MrSamuelLaw/robo-hobos/Ex 2/Media/unnamed (38).jpg

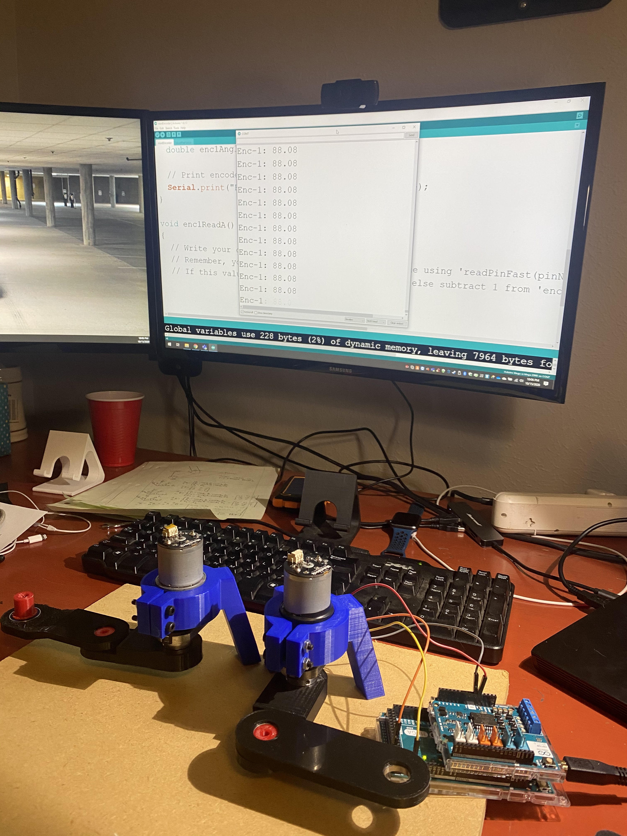
Ex 2/Media/unnamed (38).jpg
