MrSamuelLaw/robo-hobos/Ex 2/Media/unnamed (1).jpg

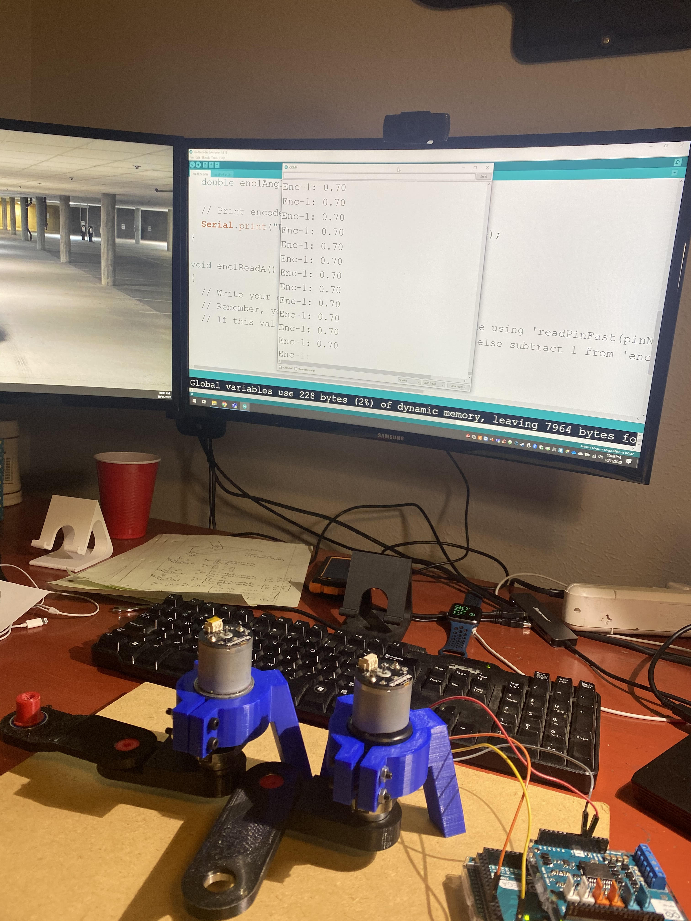
Ex 2/Media/unnamed (1).jpg
