MrSamuelLaw/robo-hobos/Ex 3/Exercise 3 Write-up.pdf

# Intro to Robotics Exercise 3

## Samuel Law & Rhys Miller

# System Diagram

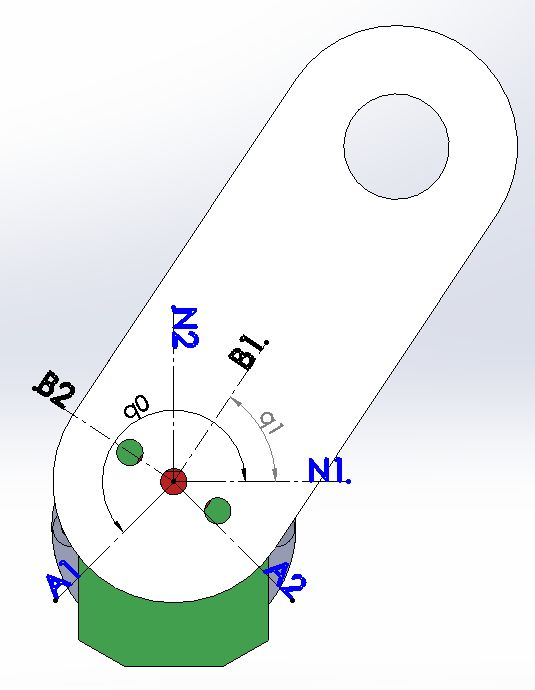
[picture p16: figure]

The system is shown below. The shaft (the top of which is a red circle) is considered body A, and the link is body B. The shaft’s A.3 axis is in the same direction as the N.3 and B.3 axis, however, the A.1 axis is at an angle q0 from the N.1 axis, not an angle q1. The COM of body A is assumed to be on its polar axis. The COM of body B is assumed to be at the dot next to the text B1. which is a distance LB away from point N, which is located at the origin.
The constraints equation is | where the q’s are the generalized coordinates and gr
is the gear ratio between the motor shaft and the motor output spindle. The constraint equation carries to both the velocity and acceleration terms.
Thus the system has two generalized coordinates, q0 and q1, and a single gear constraint equation, thus the system has a single degree of freedom
The gear ratio used in the gear constraint was printed on the side of the motor.

# Mass Properties

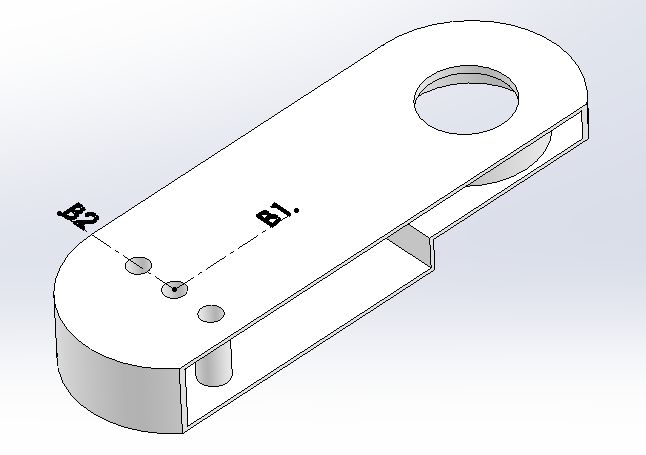
[picture p17: figure]
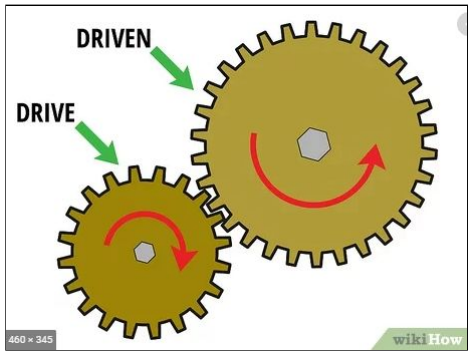
[picture p18: figure]

The mass for the link, body B, was computed using ABS mass properties from SolidWorks applied to the CAD model. The model was hollowed out, and the shell thickness set to 0.90 mm, the same as was used to print the physical model. The internally printed structure was neglected as a sparse infill was used.

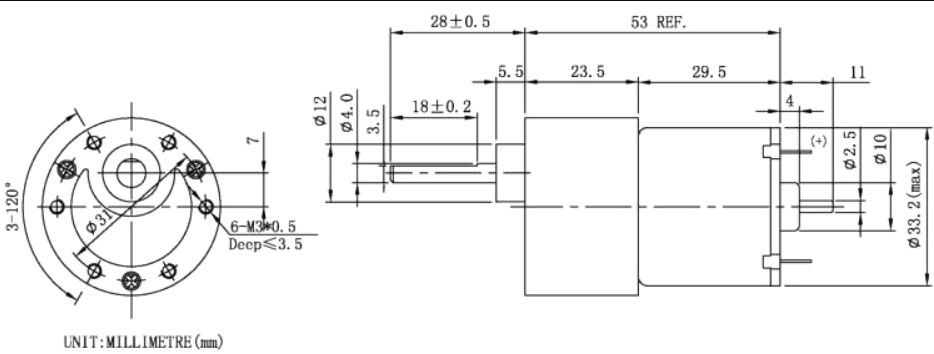
[picture p19: figure]

The mass of the axle that spins in body A was calculated using the drawing shown above. The axle was assumed to be 10.0 mm in diameter and 53 mm in length. A CAD model was generated, and the mass estimated with steel mass properties applied to the CAD model. The gears were assumed to interact in a manner similar to the ones shown below

The moments of inertia for both bodies were evaluated in the same manner as the mass properties.

Body | Mass [kg] | Izz [kg m² ]
Body A | 26.45 x 10 -3 | 3.30 x 10 -7
Body B | 7.28 x 10 -3 | 6.39 x 10 -6

# Equations of Motion

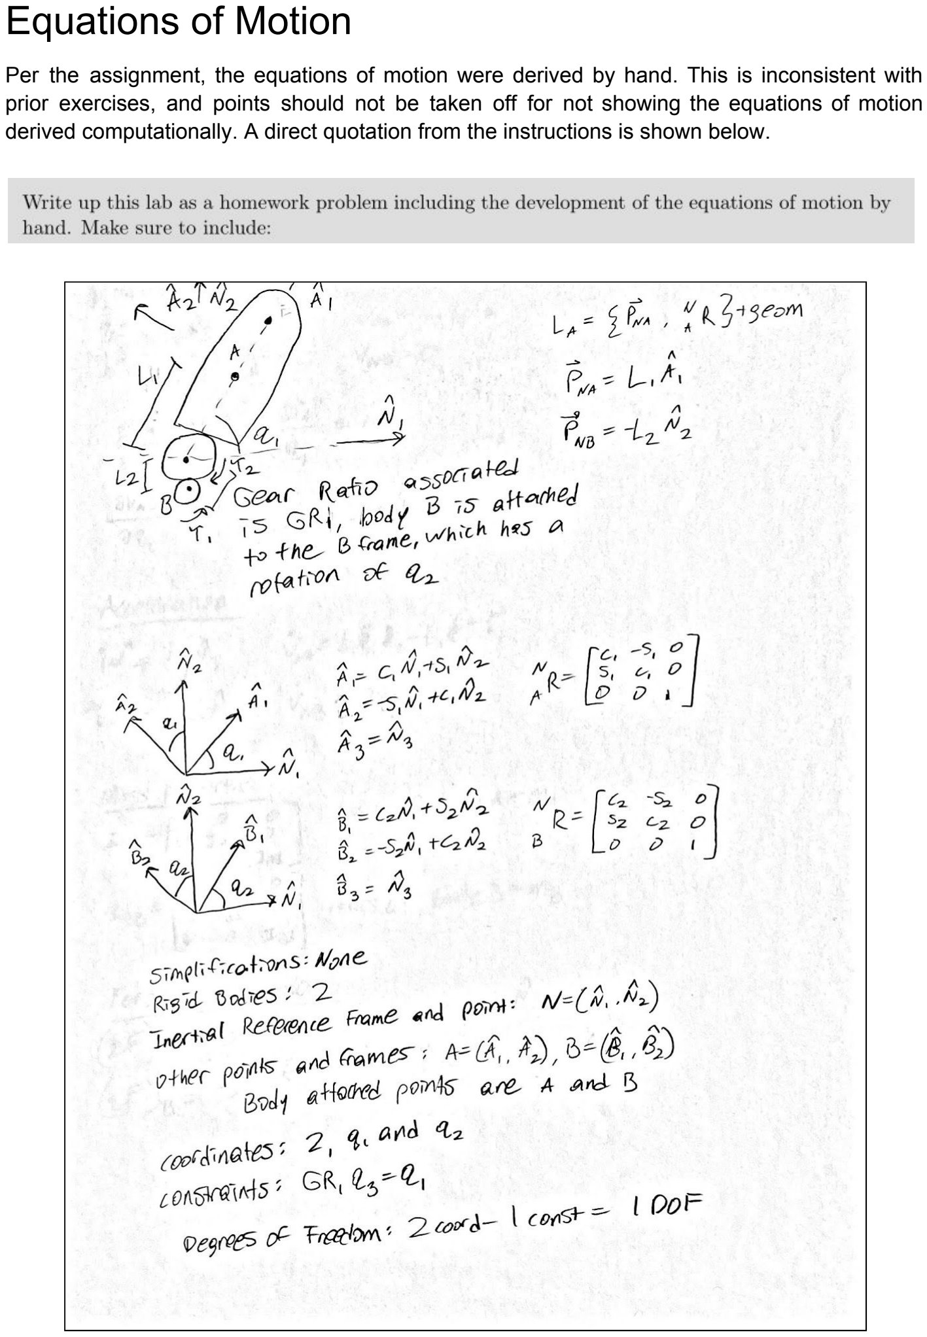
[picture p20: page 4]

Per the assignment, the equations of motion were derived by hand. This is inconsistent with prior exercises, and points should not be taken off for not showing the equations of motion derived computationally. A direct quotation from the instructions is shown below.

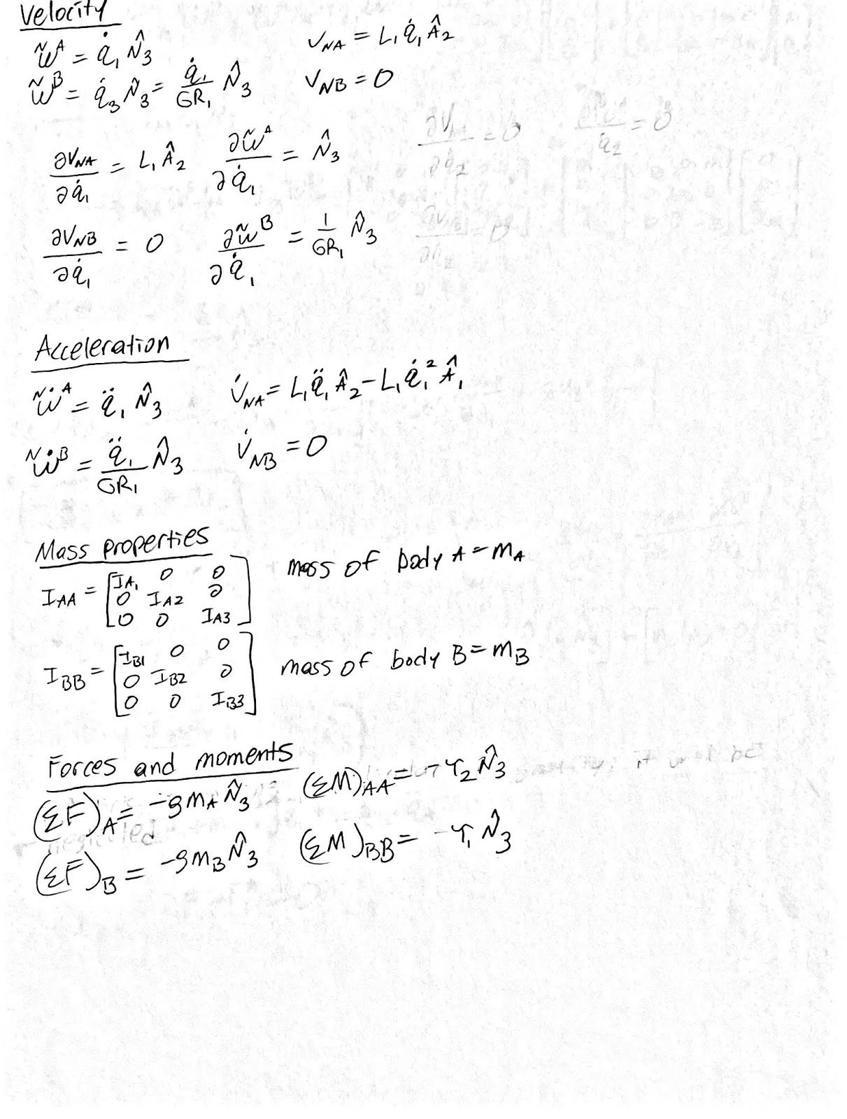
[picture p21: figure]

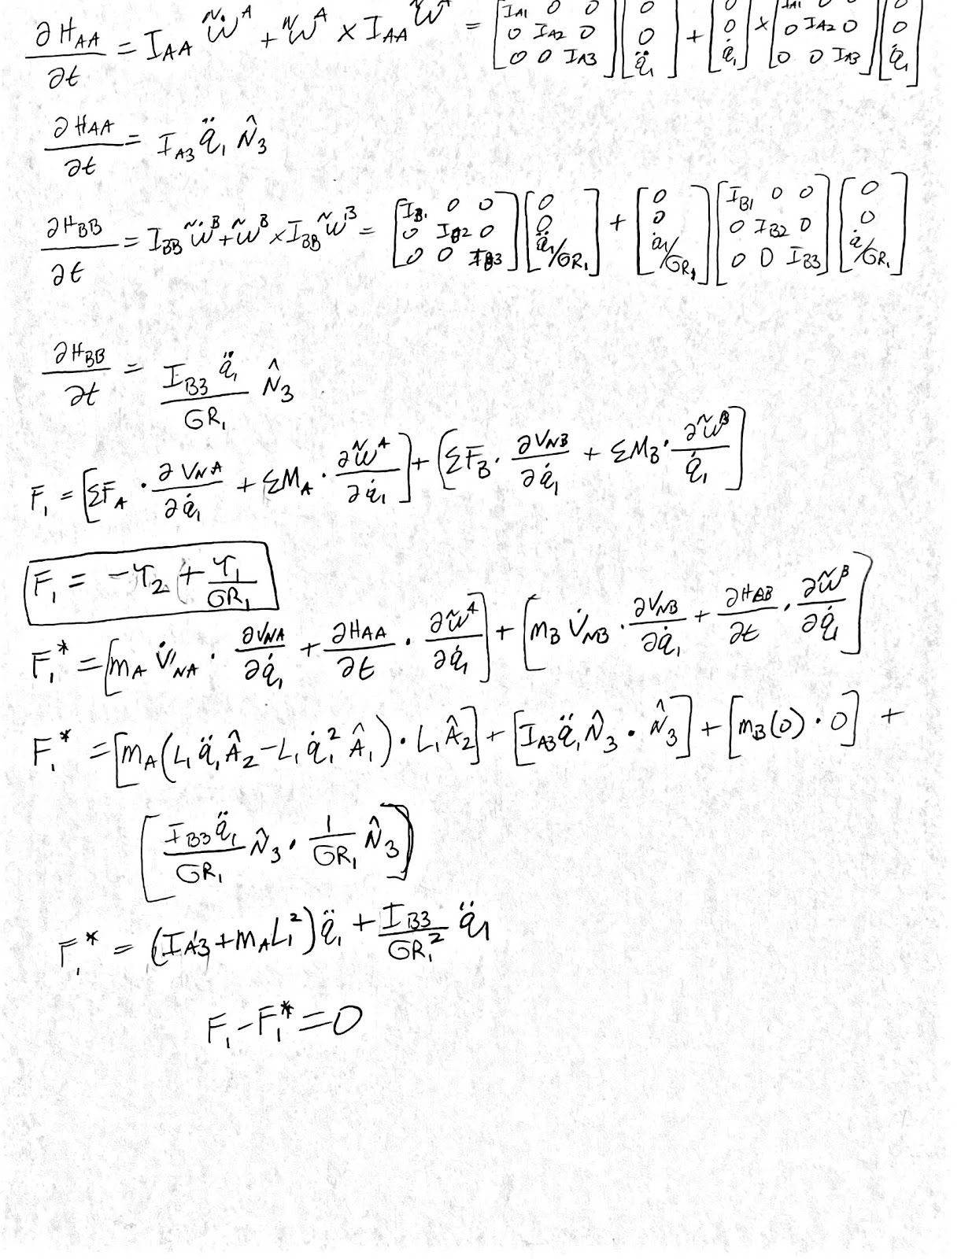
[picture p22: figure]

# Block Diagram & Discussion

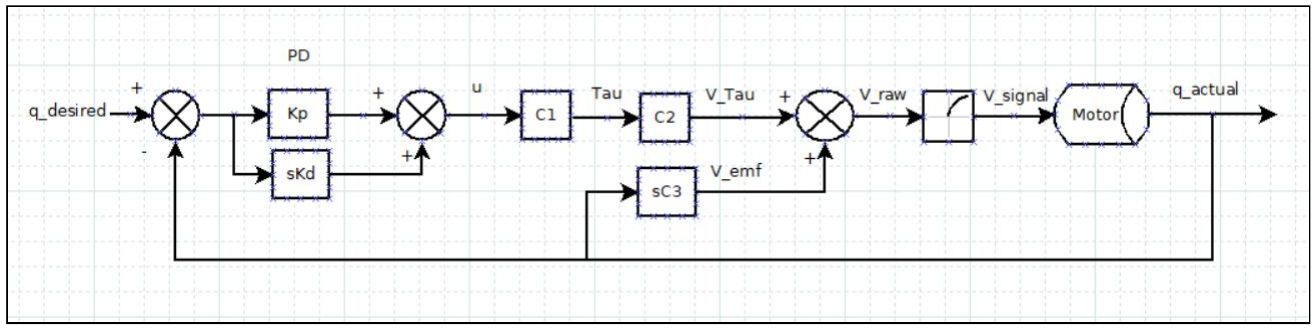
[picture p23: figure]

All simulations were performed using an RK45 integrator. The Kp value used was calculated based on the CPR of the encoder, which was set to 1000. The equation used is shown below, where Vmin is the minimum voltage required for the motor to begin moving. Vmin was determined via experimentation. For the joint space model, Kv was simply set so as to be critically damped. The saturation block between V_raw and V_signal indicates that the voltage signal was constrained between 0 and 12 volts.

The only change in the block diagram for the PD controller was that the C1 block was removed, thus eliminating any kind of compensation for mass properties. This meant that the controller had to be tuned in order to work correctly.

# Joint Space Simulation & Experiment Results

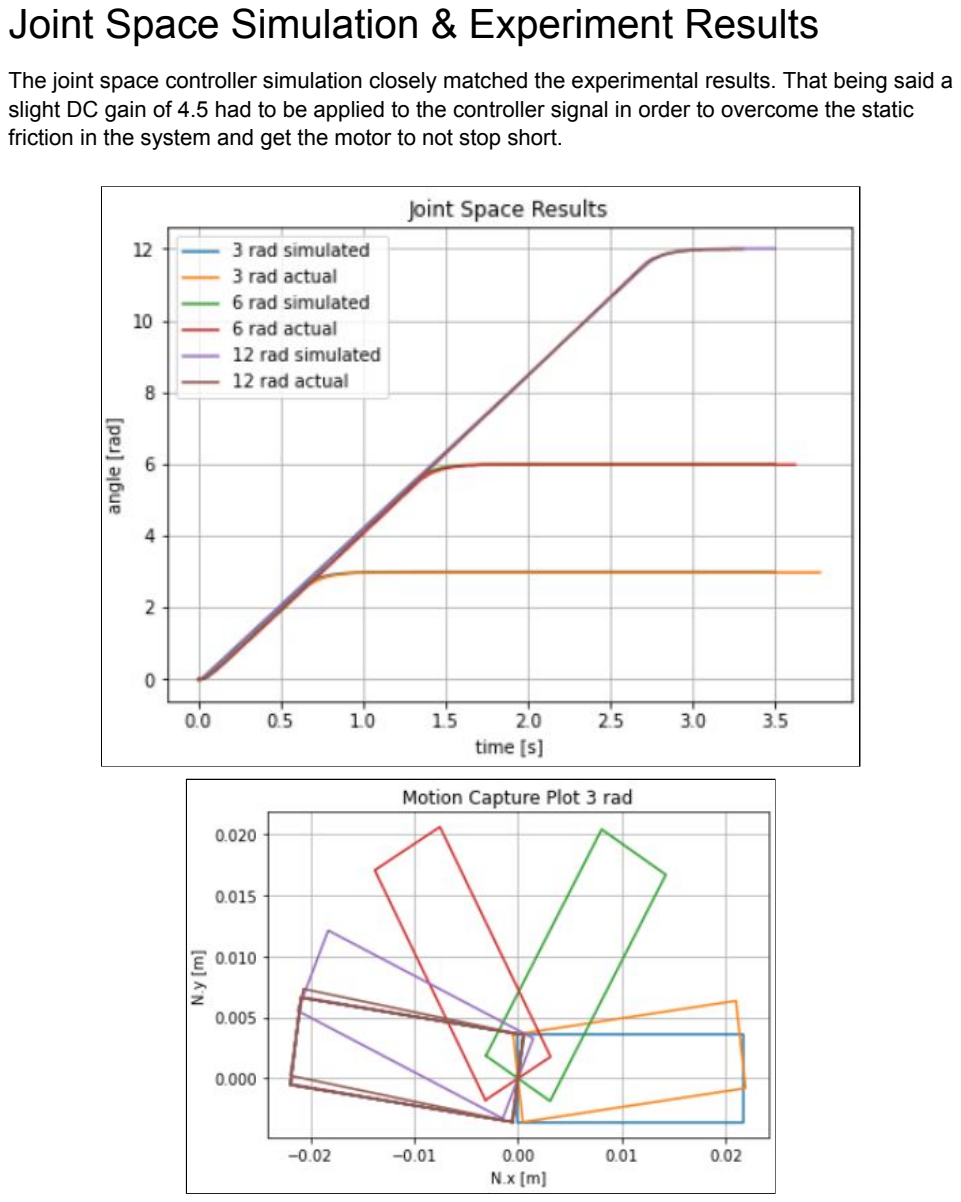
[picture p24: page 8]

The joint space controller simulation closely matched the experimental results. That being said a slight DC gain of 4.5 had to be applied to the controller signal in order to overcome the static friction in the system and get the motor to not stop short.

# PD Simulation & Experiment Results

The PD controller did not behave as simulated. Due to the massive increase in the strength of the signal, as C1 was a very small number and now was absent from the controller, the controller required a DC gain of 0.5 to function in the realm of normal. There was also substantial vibration. A PID controller is recommended as it would allow for lower Kp and Kv values, while not undershooting the target.

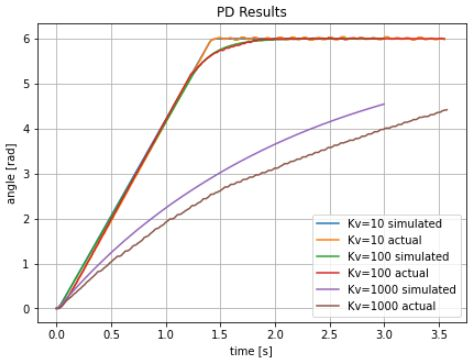
[picture p25: figure]

# Team Photo (note, only one person due to COVID)

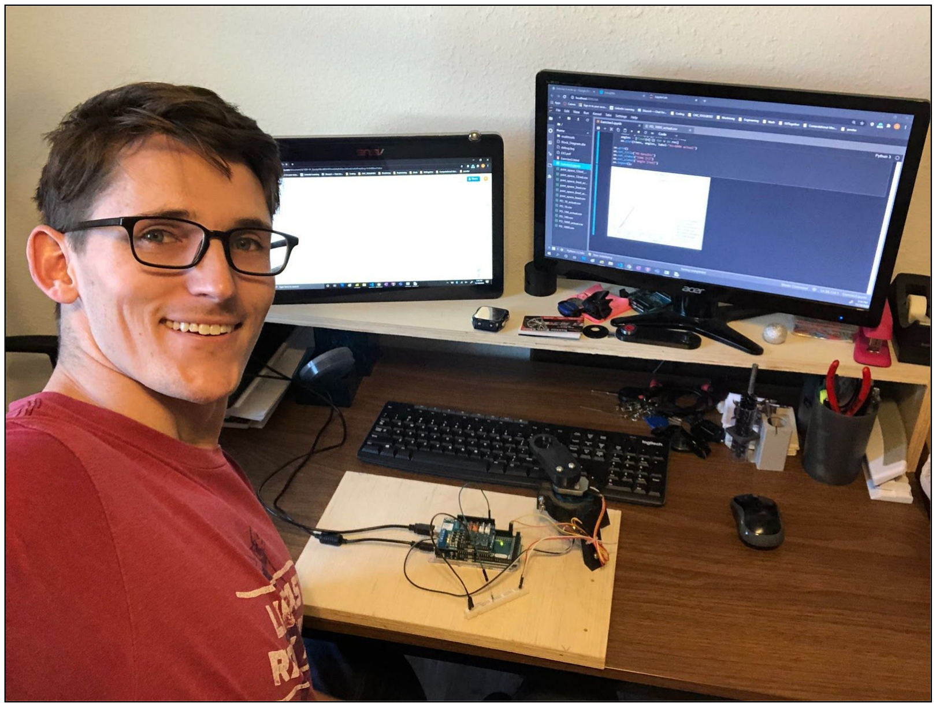
[picture p26: figure]

# References

[gears] https://www.wikihow.com/Determine-Gear-Ratio
