MrSamuelLaw/robo-hobos/pdf_files/MAE 4345 EX1 (2).pdf

# MAE 4345 Exercise 1 Samuel Law & Rhys Miller

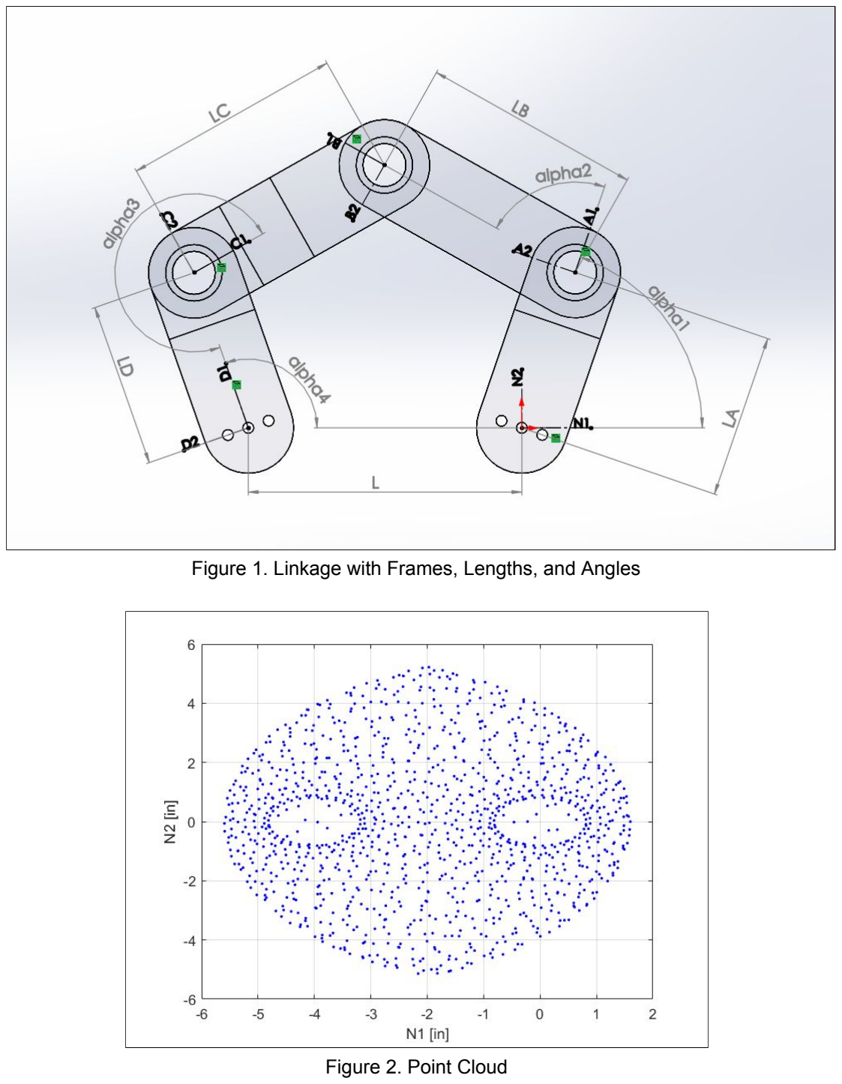
[picture p27: page 2]

Figure 1. Linkage with Frames, Lengths, and Angles

Figure 2. Point Cloud

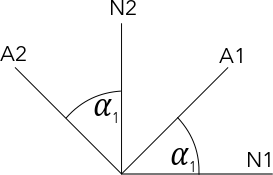
[picture p28: figure]

ℒ
A

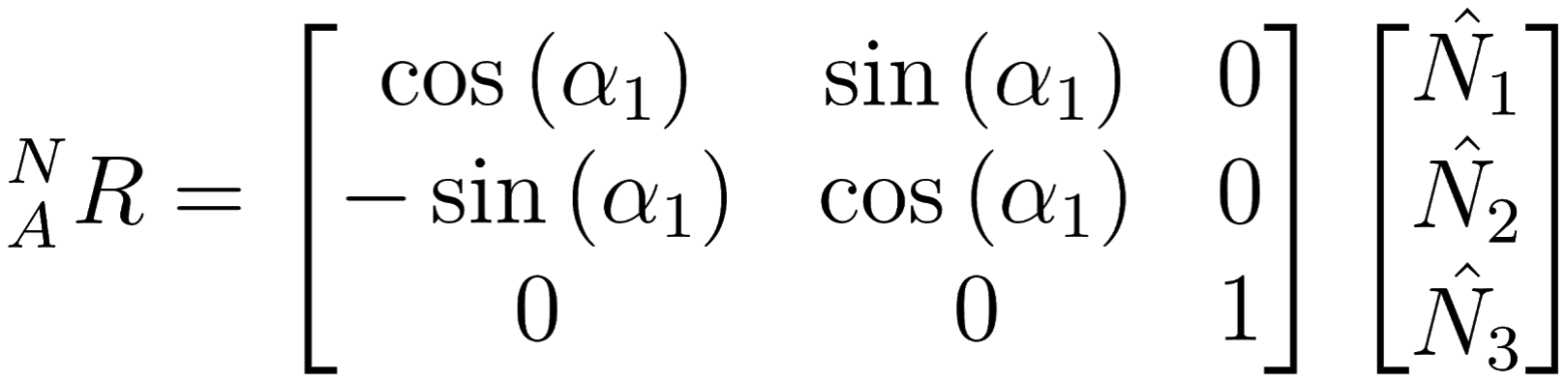
[picture p29: figure]
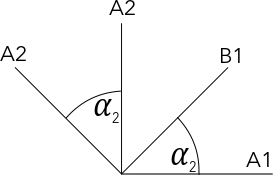
[picture p30: figure]

ℒ
B

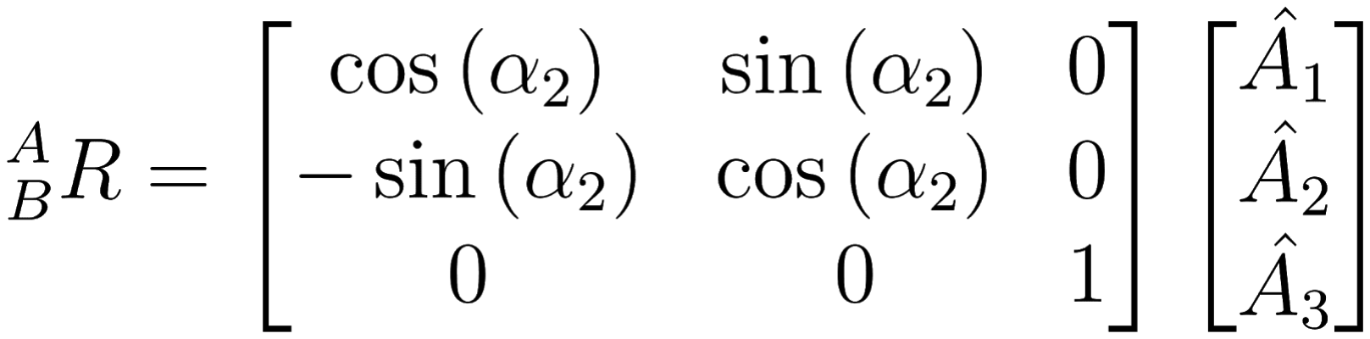
[picture p31: figure]

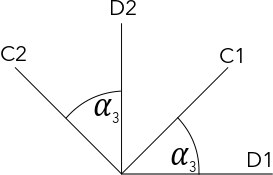
[picture p32: figure]

ℒ
C

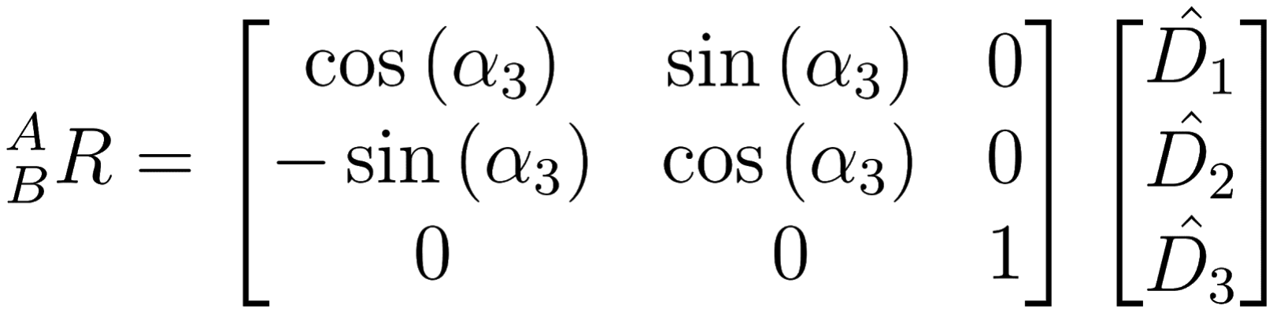
[picture p33: figure]
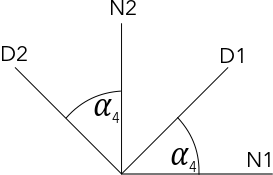
[picture p34: figure]

ℒ
D

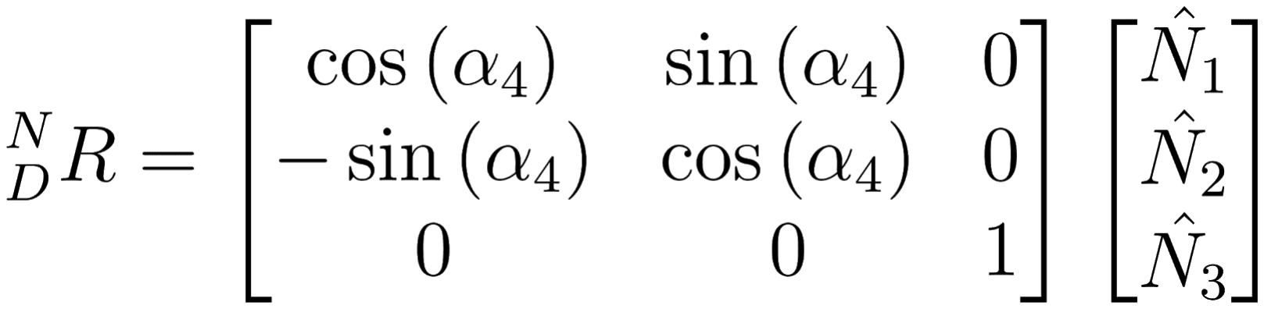
[picture p35: figure]

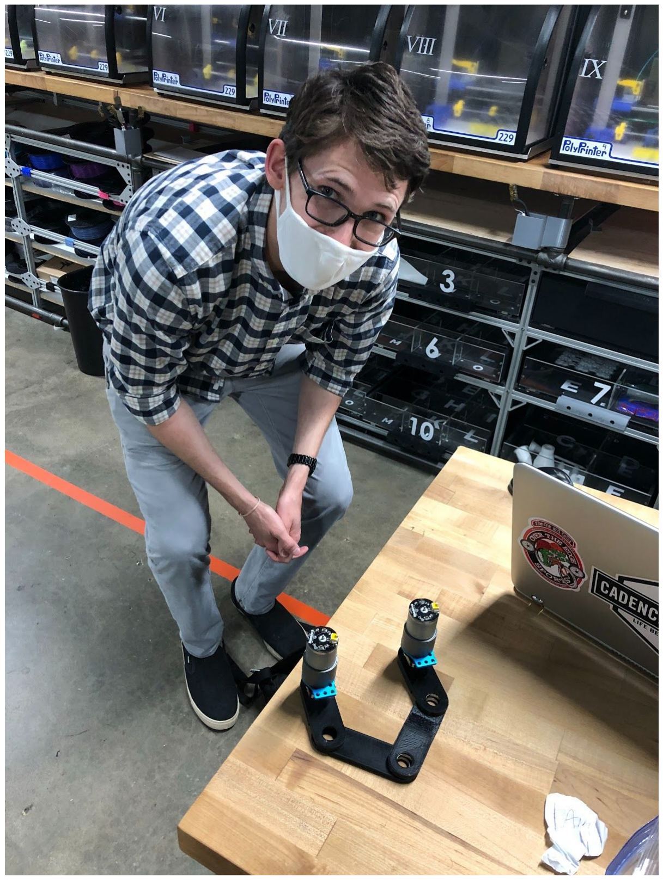
[picture p36: figure]

Img 1. Robot!
