MrSamuelLaw/robo-hobos/Ex 2/Media/unnamed.jpg

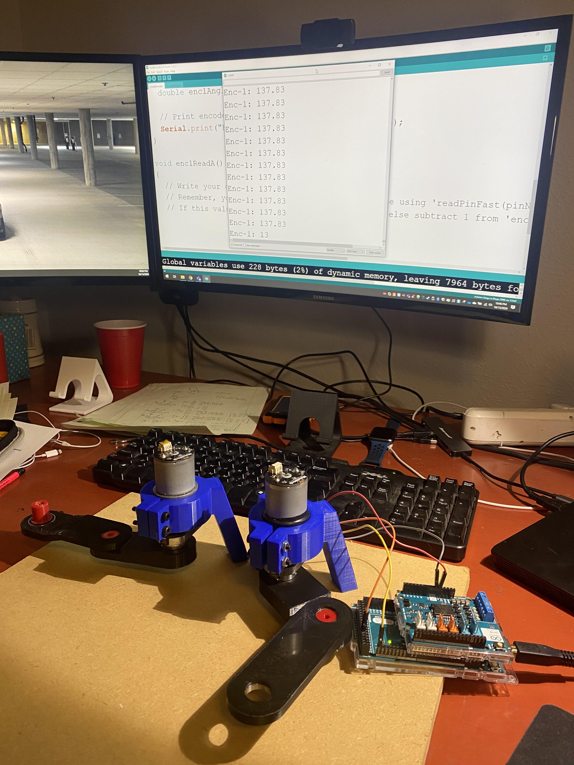
Ex 2/Media/unnamed.jpg
