MrSamuelLaw/robo-hobos/Ex 2/Media/WIN_20201015_22_07_46_Pro.jpg

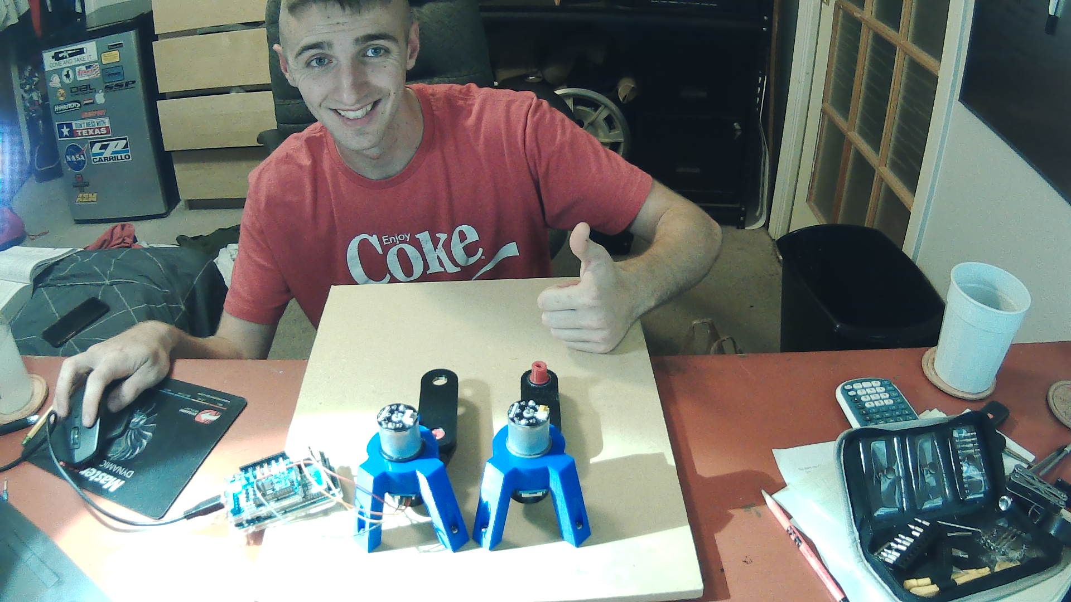
Ex 2/Media/WIN_20201015_22_07_46_Pro.jpg
