MrSamuelLaw/robo-hobos/Ex 2/Writeup/Diagram.JPG

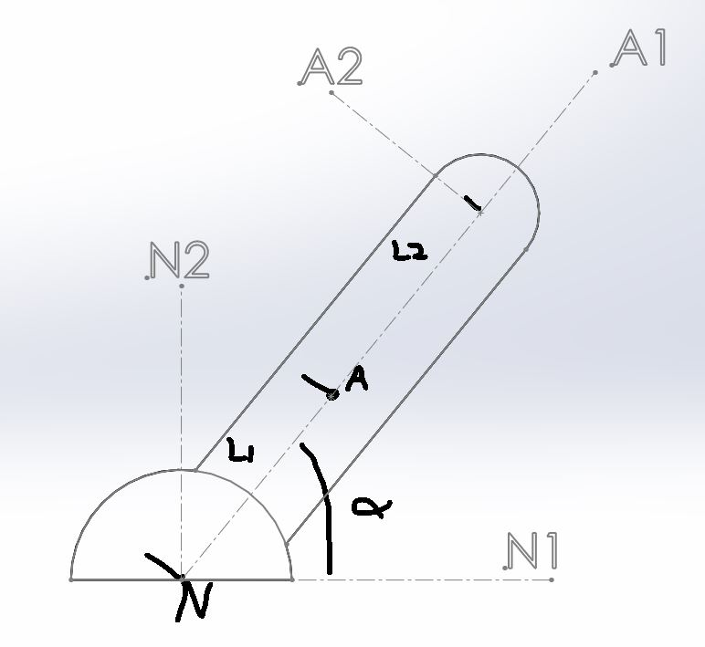
Ex 2/Writeup/Diagram.JPG
