MrSamuelLaw/robo-hobos/images/point_cloud.png

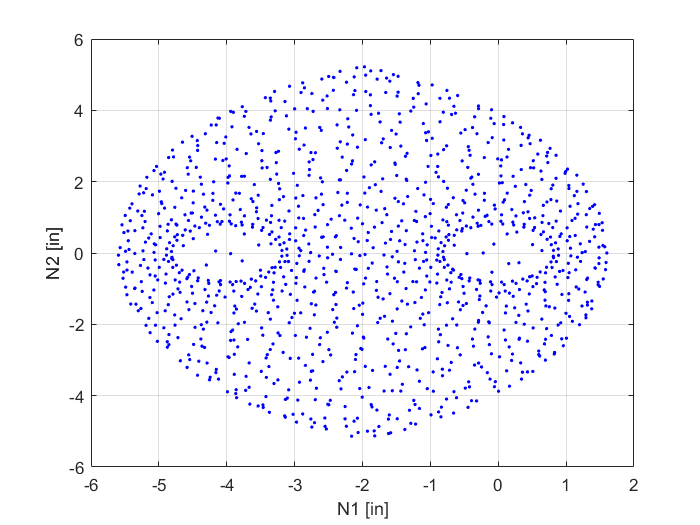
images/point_cloud.png
