MrSamuelLaw/robo-hobos/Solidworks_files/linkage_diagram.png

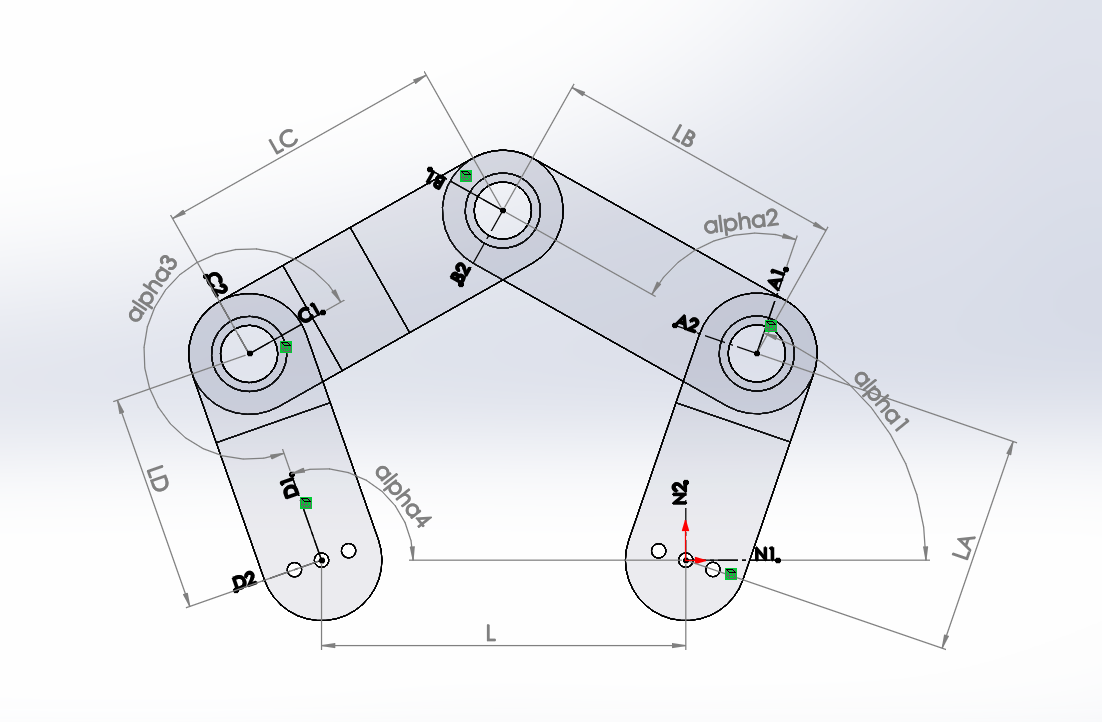
Solidworks_files/linkage_diagram.png
