MrSamuelLaw/robo-hobos/Solidworks_files/asm_robot.SLDASM

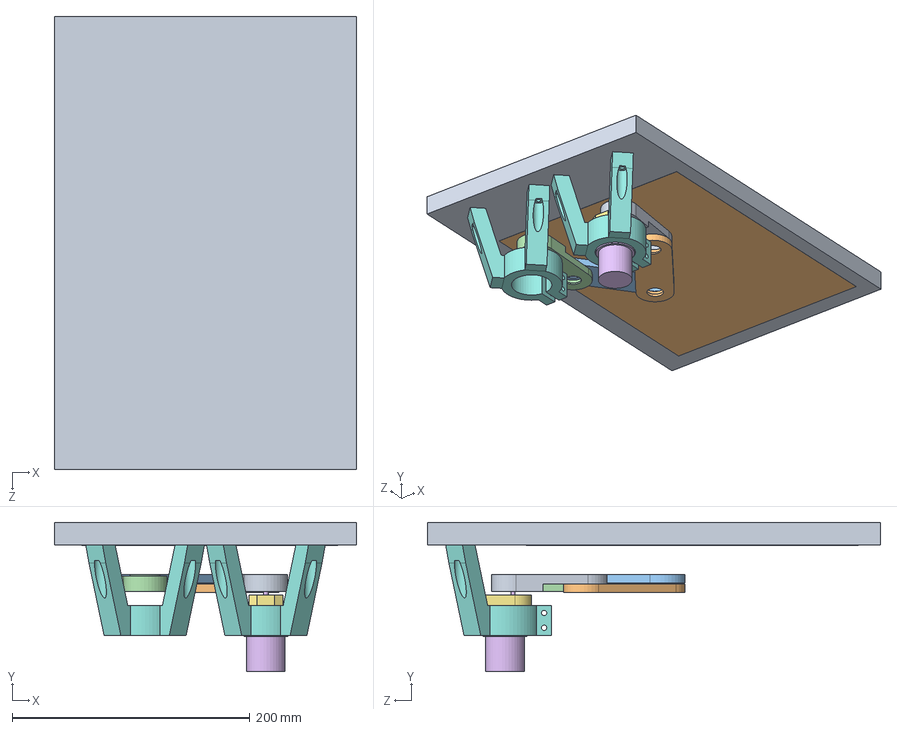
[picture p42: CAD file, 2020-11-30]
Solidworks_files/asm_robot.SLDASM
254.0 x 125.3 x 381.0 mm
linkA
linkB
linkC
linkD
Motor Mount x 2
wood_base
paper
