MrSamuelLaw/robo-hobos/Solidworks_files/asm_motor_encoder_adapter.SLDASM

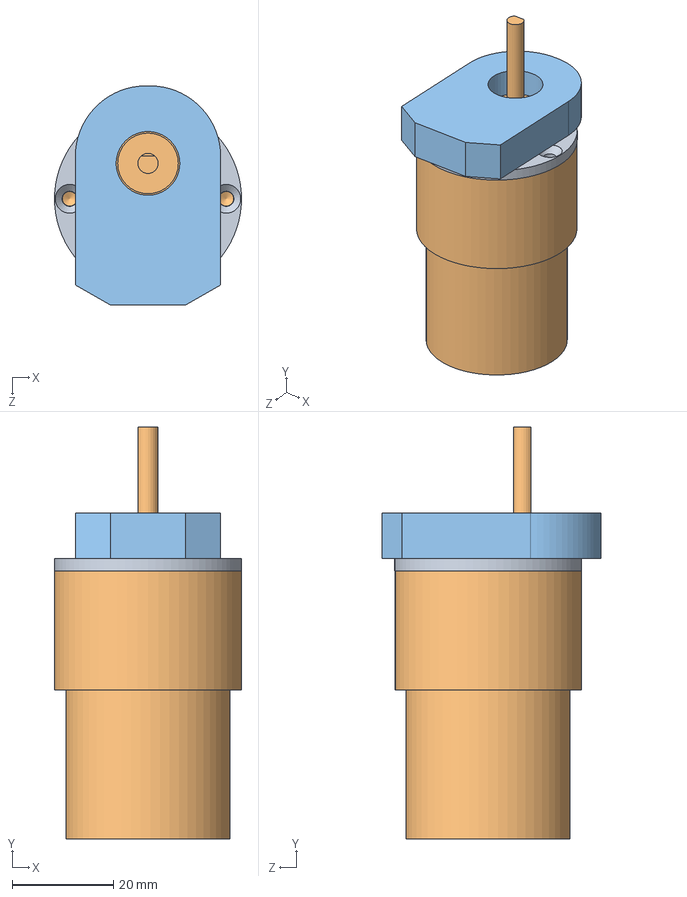
[picture p43: CAD file, 2020-10-02]
Solidworks_files/asm_motor_encoder_adapter.SLDASM
37.0 x 81.5 x 43.4 mm
Encoder_Adaptor
Gearmotor
Encoder
