MrSamuelLaw/robo-hobos/Solidworks_files/asm_linkages.SLDASM

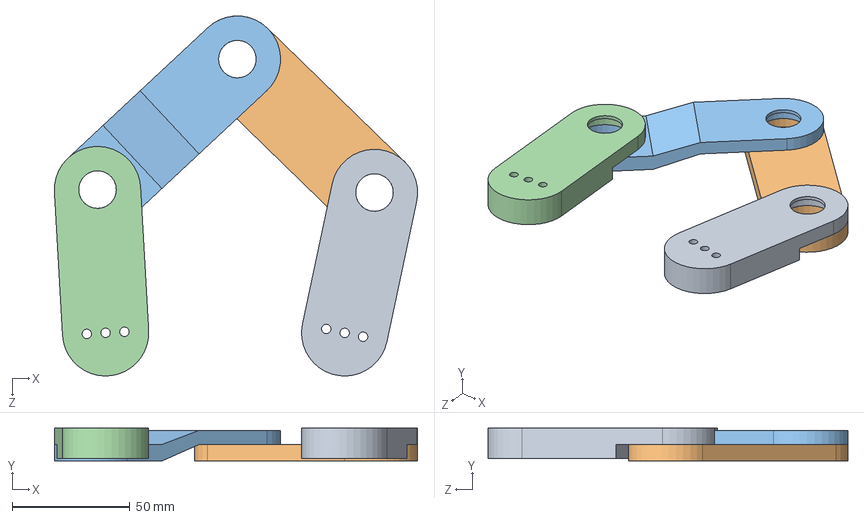
[picture p44: CAD file, 2020-09-29]
Solidworks_files/asm_linkages.SLDASM
154.3 x 14.0 x 153.0 mm
linkA
linkB
linkC
linkD
