MrSamuelLaw/robo-hobos/Ex 2/Writeup/Pendulum.SLDPRT

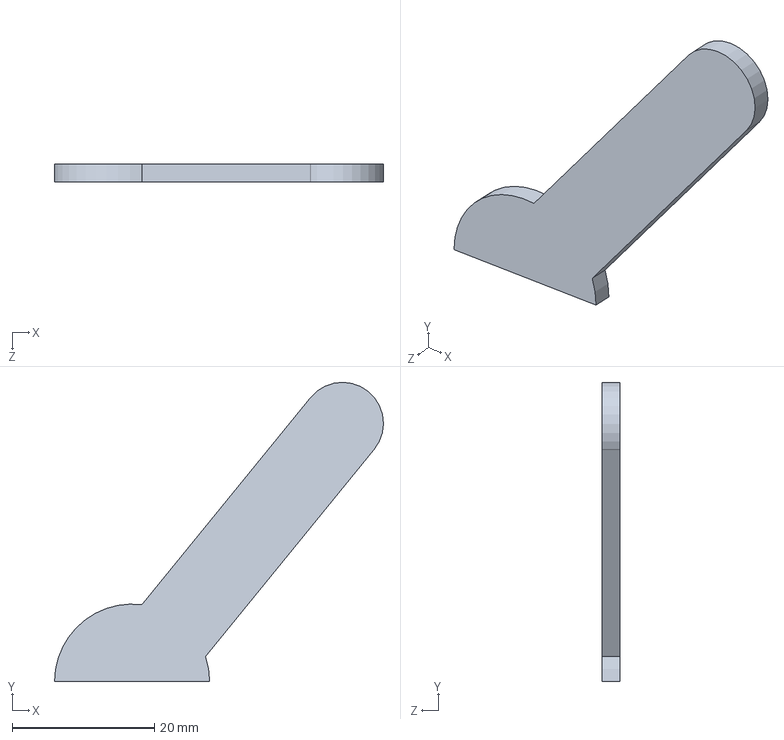
[picture p45: CAD file, 2020-11-10]
Ex 2/Writeup/Pendulum.SLDPRT
46.3 x 42.2 x 2.54 mm
