MrSamuelLaw/robo-hobos/Solidworks_files/dxf_files/board_mount-drawing.DXF

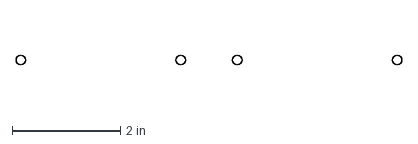
[picture p46: CAD file, 2020-10-05]
Solidworks_files/dxf_files/board_mount-drawing.DXF
7.13 x 0.177 in
