MrSamuelLaw/robo-hobos/Solidworks_files/linkC.SLDPRT

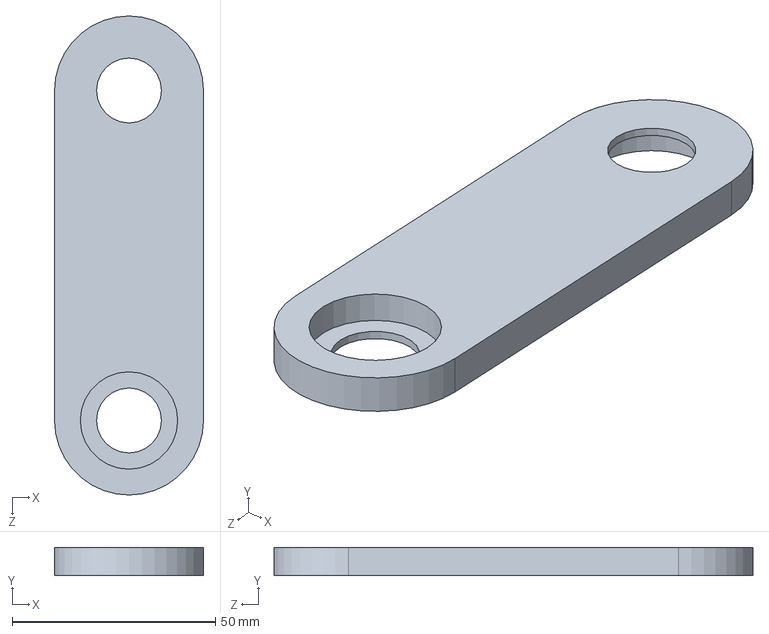
[picture p47: CAD file, 2020-11-29]
Solidworks_files/linkC.SLDPRT
36.7 x 7.00 x 118.0 mm
