MrSamuelLaw/robo-hobos/Solidworks_files/shaft_estimation.SLDPRT

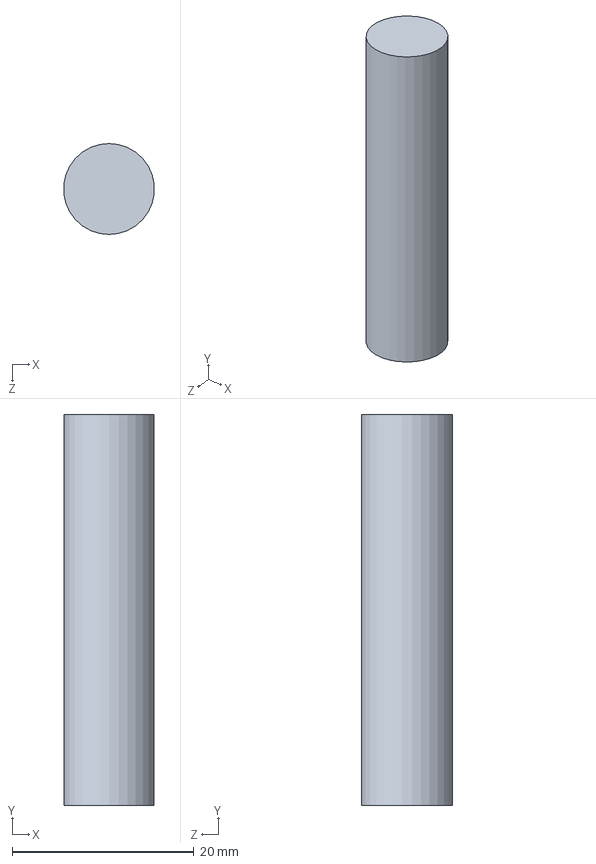
[picture p48: CAD file, 2020-11-29]
Solidworks_files/shaft_estimation.SLDPRT
9.95 x 43.0 x 10.0 mm
