MrSamuelLaw/robo-hobos/Solidworks_files/linkA.SLDPRT

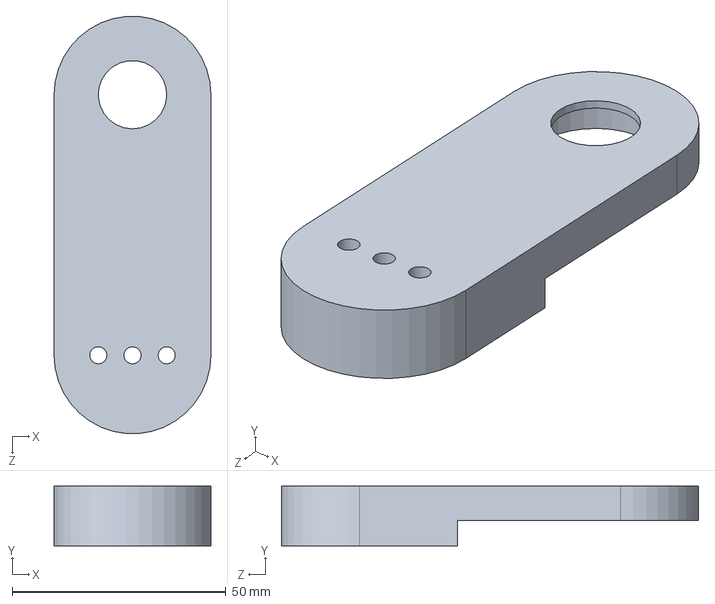
[picture p49: CAD file, 2020-11-29]
Solidworks_files/linkA.SLDPRT
36.7 x 14.0 x 97.5 mm
