MrSamuelLaw/robo-hobos/Solidworks_files/linkD.SLDPRT

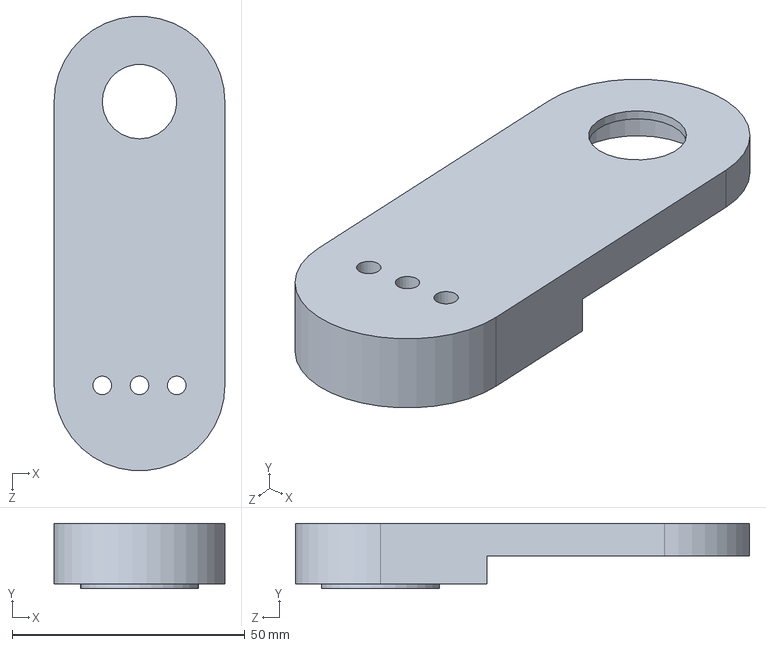
[picture p50: CAD file, 2020-11-29]
Solidworks_files/linkD.SLDPRT
36.7 x 14.0 x 97.5 mm
