MrSamuelLaw/robo-hobos/Solidworks_files/end_effector.SLDPRT

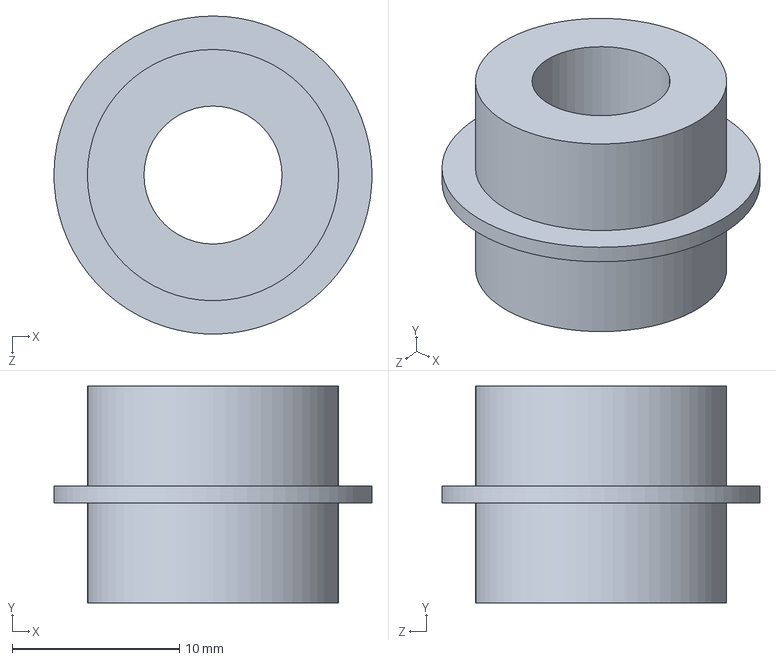
[picture p51: CAD file, 2020-11-10]
Solidworks_files/end_effector.SLDPRT
19.0 x 13.0 x 19.0 mm
