MrSamuelLaw/robo-hobos/Solidworks_files/paper.SLDPRT

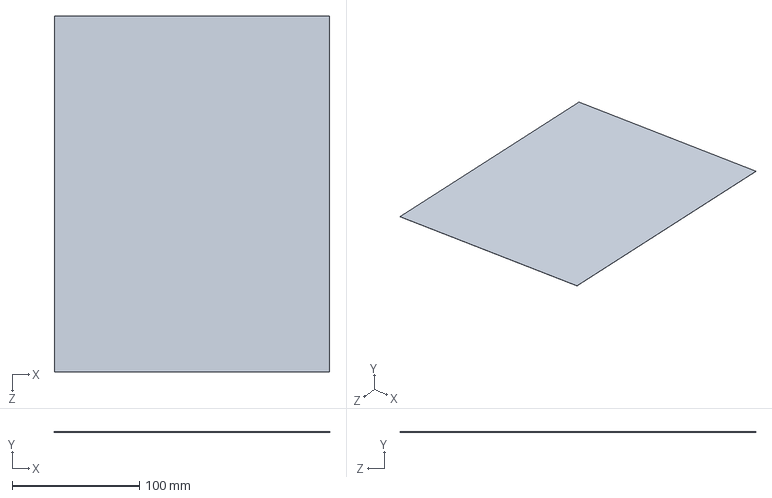
[picture p52: CAD file, 2020-10-05]
Solidworks_files/paper.SLDPRT
215.9 x 0.127 x 279.4 mm
