MrSamuelLaw/robo-hobos/Solidworks_files/wood_base.SLDPRT

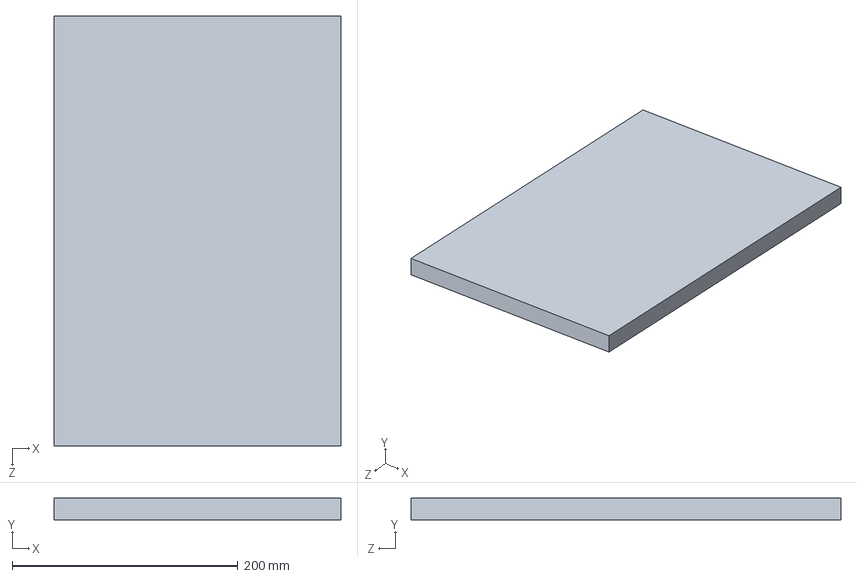
[picture p53: CAD file, 2020-10-05]
Solidworks_files/wood_base.SLDPRT
254.0 x 19.1 x 381.0 mm
