MrSamuelLaw/robo-hobos/Solidworks_files/linkB.SLDPRT

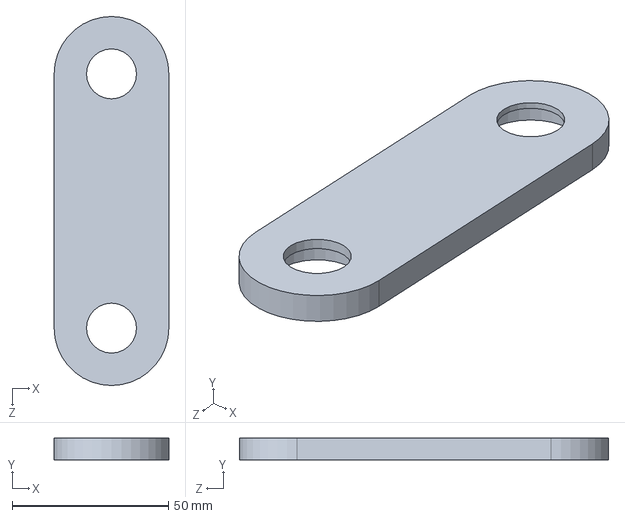
[picture p54: CAD file, 2020-10-02]
Solidworks_files/linkB.SLDPRT
36.7 x 7.00 x 118.0 mm
