MrSamuelLaw/robo-hobos/Solidworks_files/Motor Mount.SLDPRT

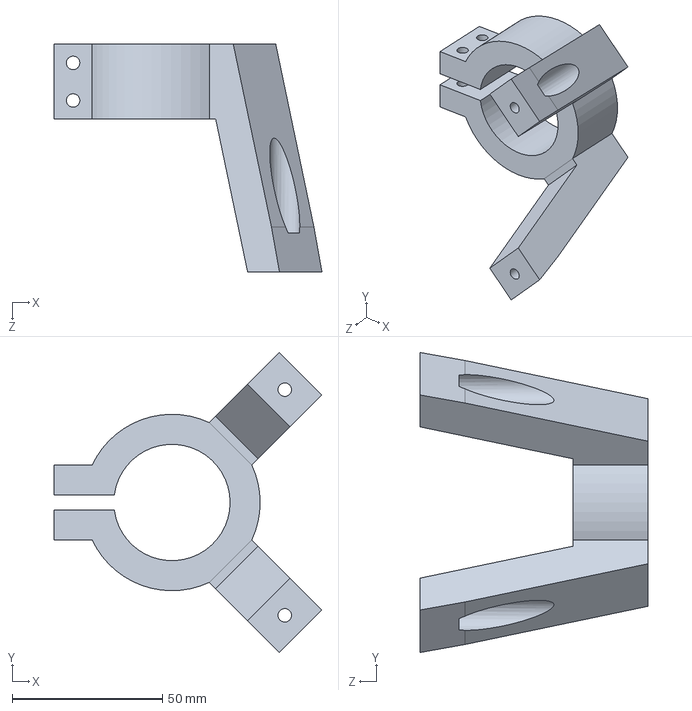
[picture p55: CAD file, 2020-10-02]
Solidworks_files/Motor Mount.SLDPRT
89.2 x 99.8 x 75.8 mm
