MrSamuelLaw/robo-hobos/Solidworks_files/Gearmotor.SLDPRT

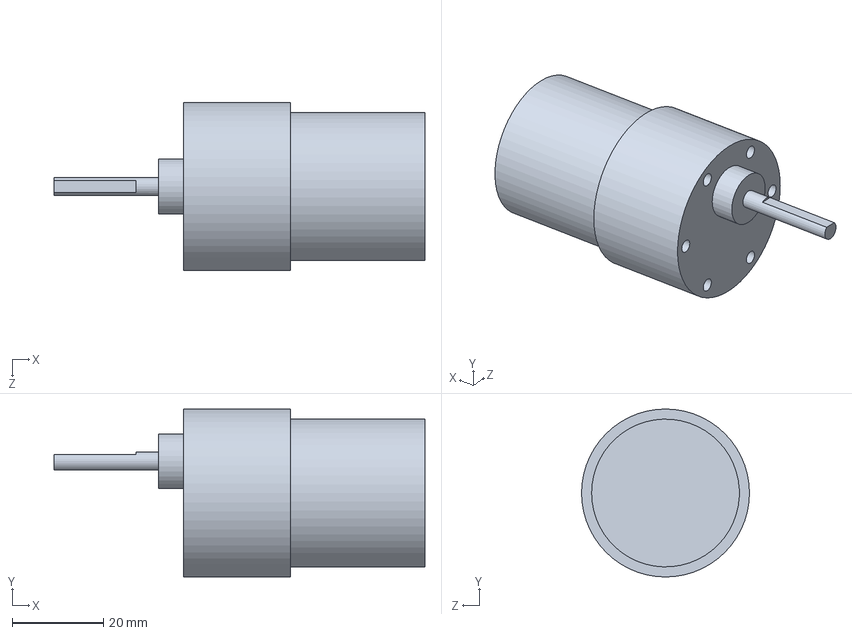
[picture p56: CAD file, 2020-10-02]
Solidworks_files/Gearmotor.SLDPRT
81.5 x 36.9 x 36.9 mm
