MrSamuelLaw/robo-hobos/Solidworks_files/Encoder.SLDPRT

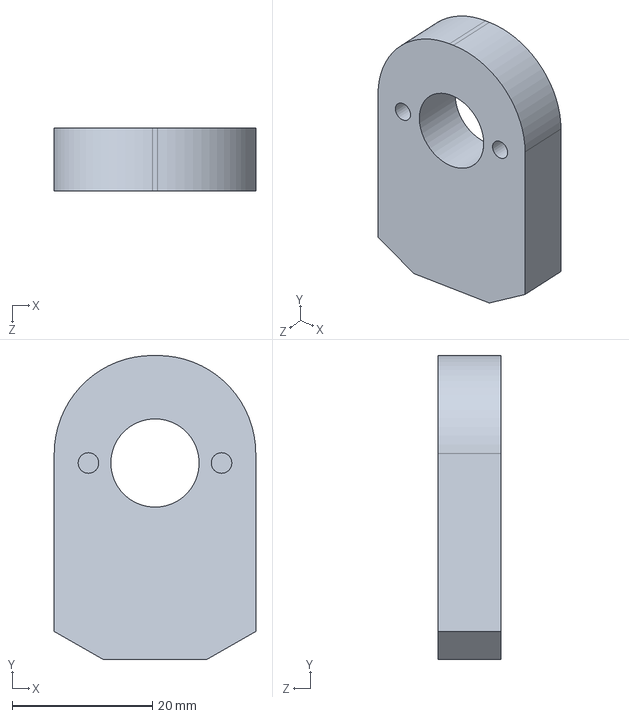
[picture p57: CAD file, 2020-09-29]
Solidworks_files/Encoder.SLDPRT
28.8 x 43.4 x 9.00 mm
