MrSamuelLaw/robo-hobos/Solidworks_files/Encoder_Adaptor.SLDPRT

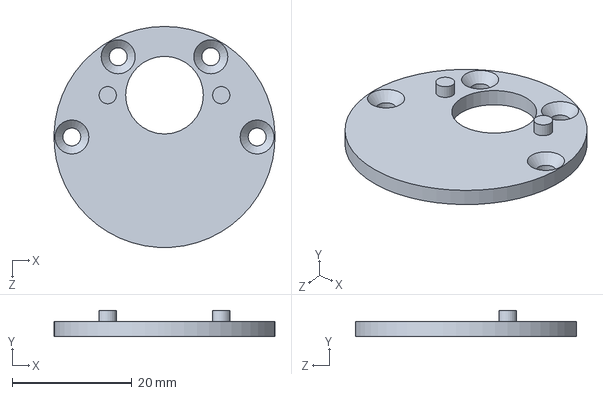
[picture p58: CAD file, 2020-09-29]
Solidworks_files/Encoder_Adaptor.SLDPRT
37.0 x 4.40 x 37.0 mm
