MrSamuelLaw/robo-hobos/Solidworks_files/linkage_spacer.SLDPRT

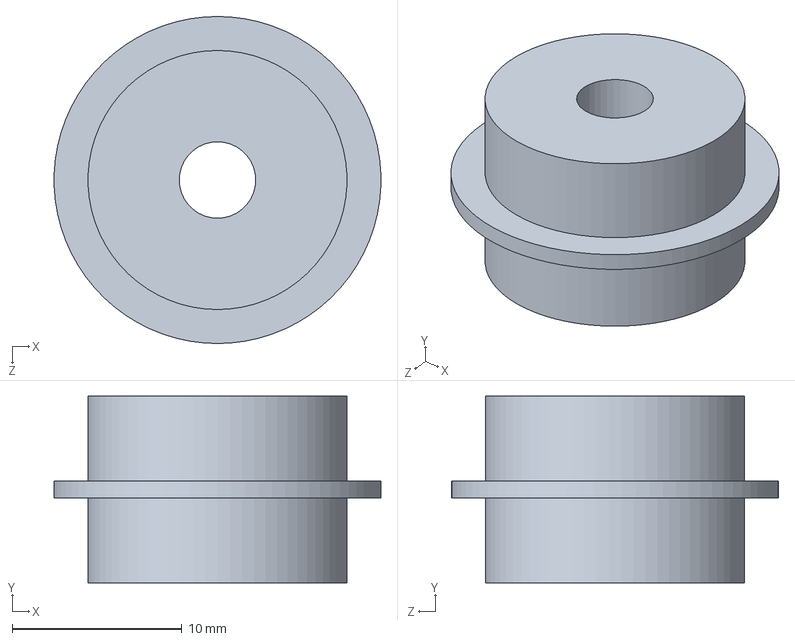
[picture p59: CAD file, 2020-09-29]
Solidworks_files/linkage_spacer.SLDPRT
19.2 x 11.0 x 19.2 mm
