MrSamuelLaw/robo-hobos/(list of files, cad)

Other CAD files:
Solidworks_files/Nframe.SLDPRT
Solidworks_files/asm_robot.SLDPRT
Solidworks_files/linkage_washer.SLDPRT
Solidworks_files/stl_files/Motor Mount.STL
Solidworks_files/stl_files/linkA.STL
