MrSamuelLaw/robo-hobos/pdf_files/Exercise1_Report_w_pic.pdf

# MAE 4345 Exercise 1 Samuel Law & Rhys Miller


Figure 1. Linkage with Frames, Lengths, and Angles

Figure 2. Point Cloud


ℒ
A


ℒ
B



ℒ
C


ℒ
D



Img 1. Robot!

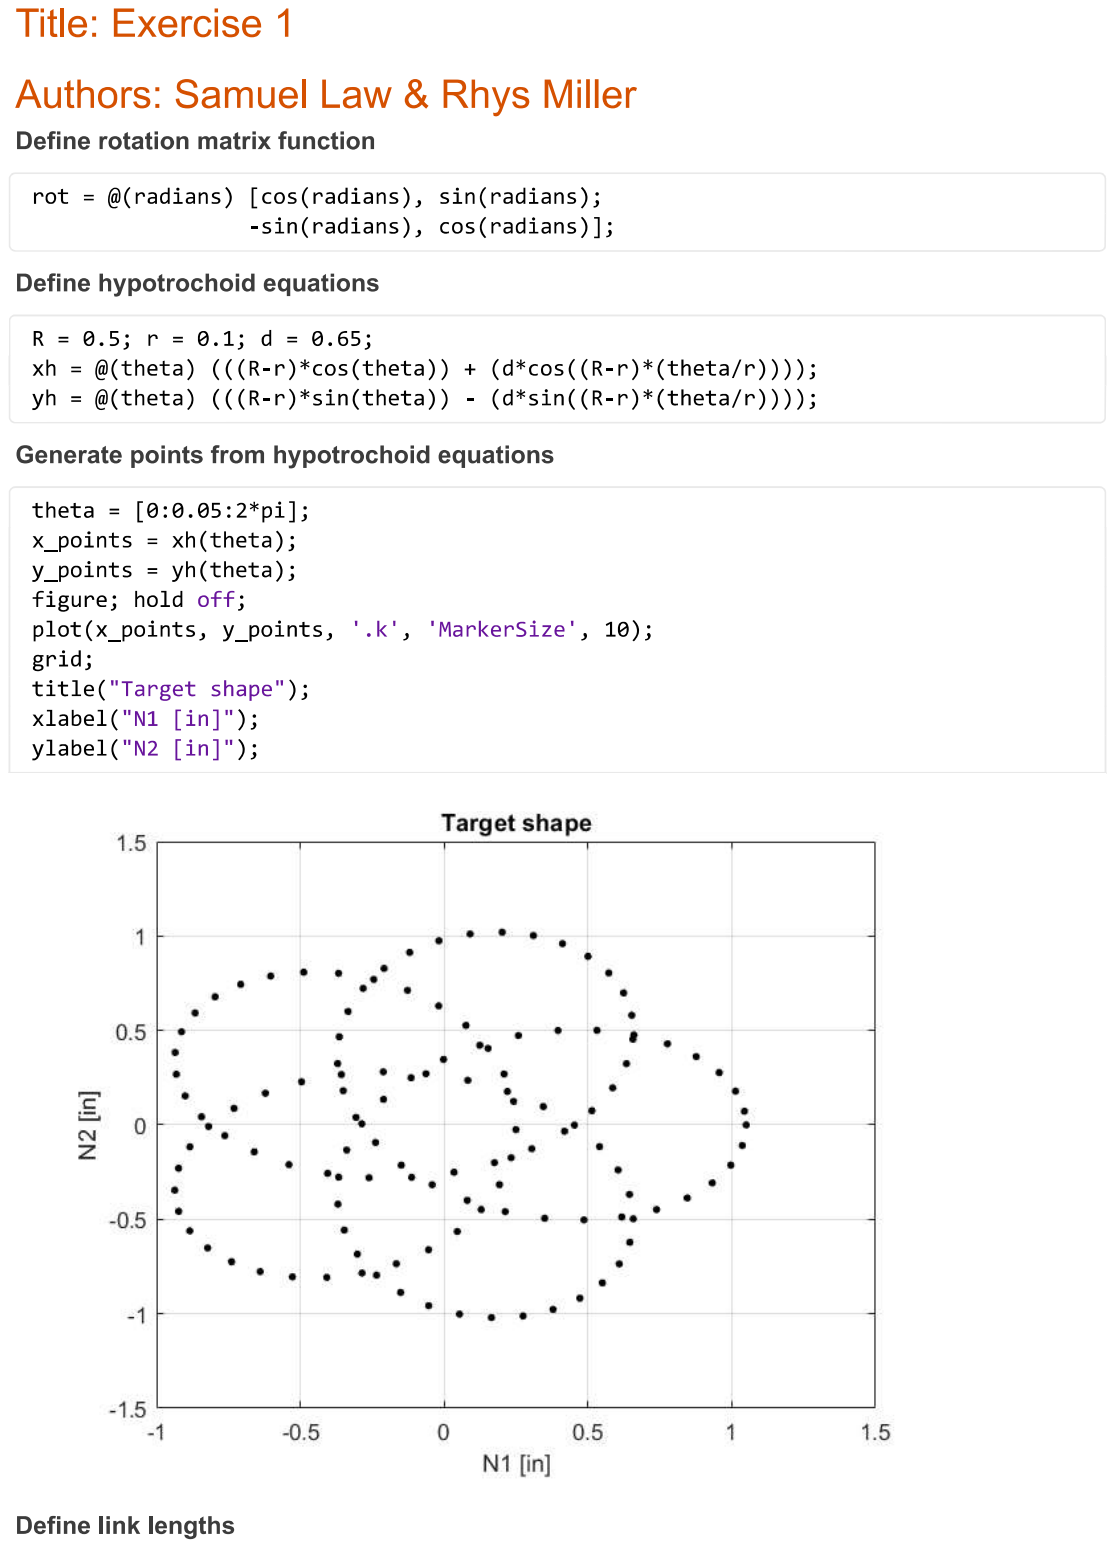
[picture p60: page 6]

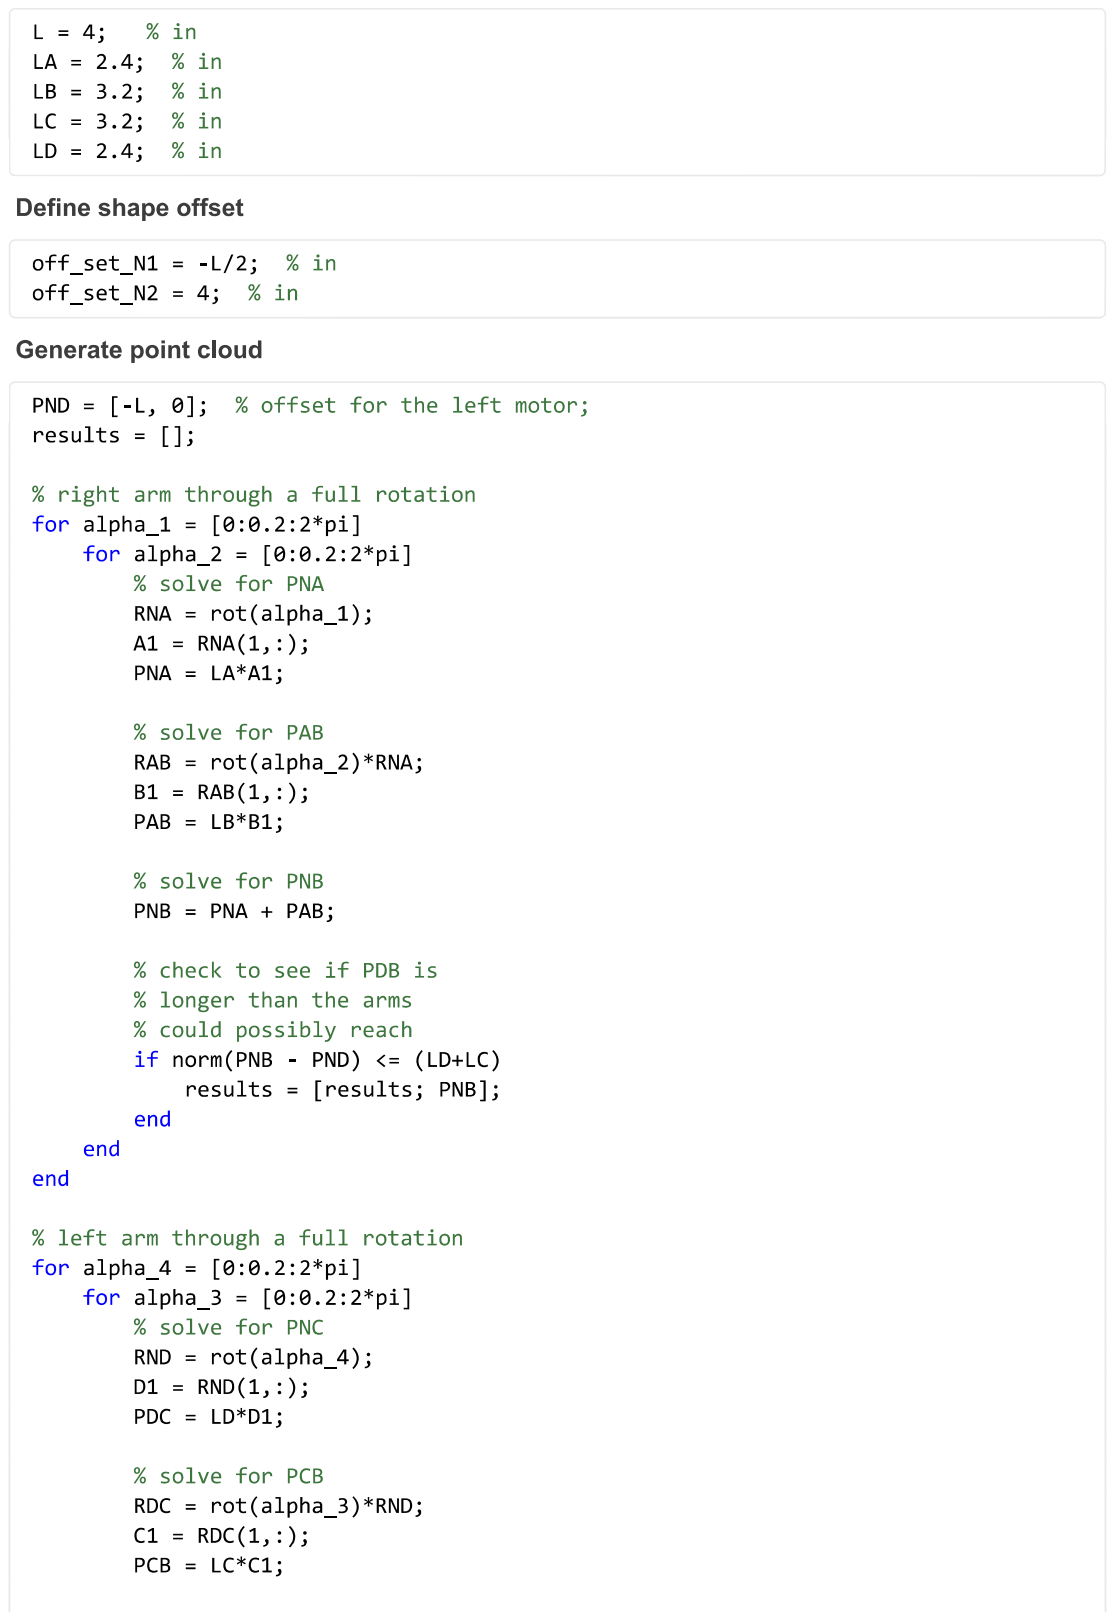
[picture p61: page 7]

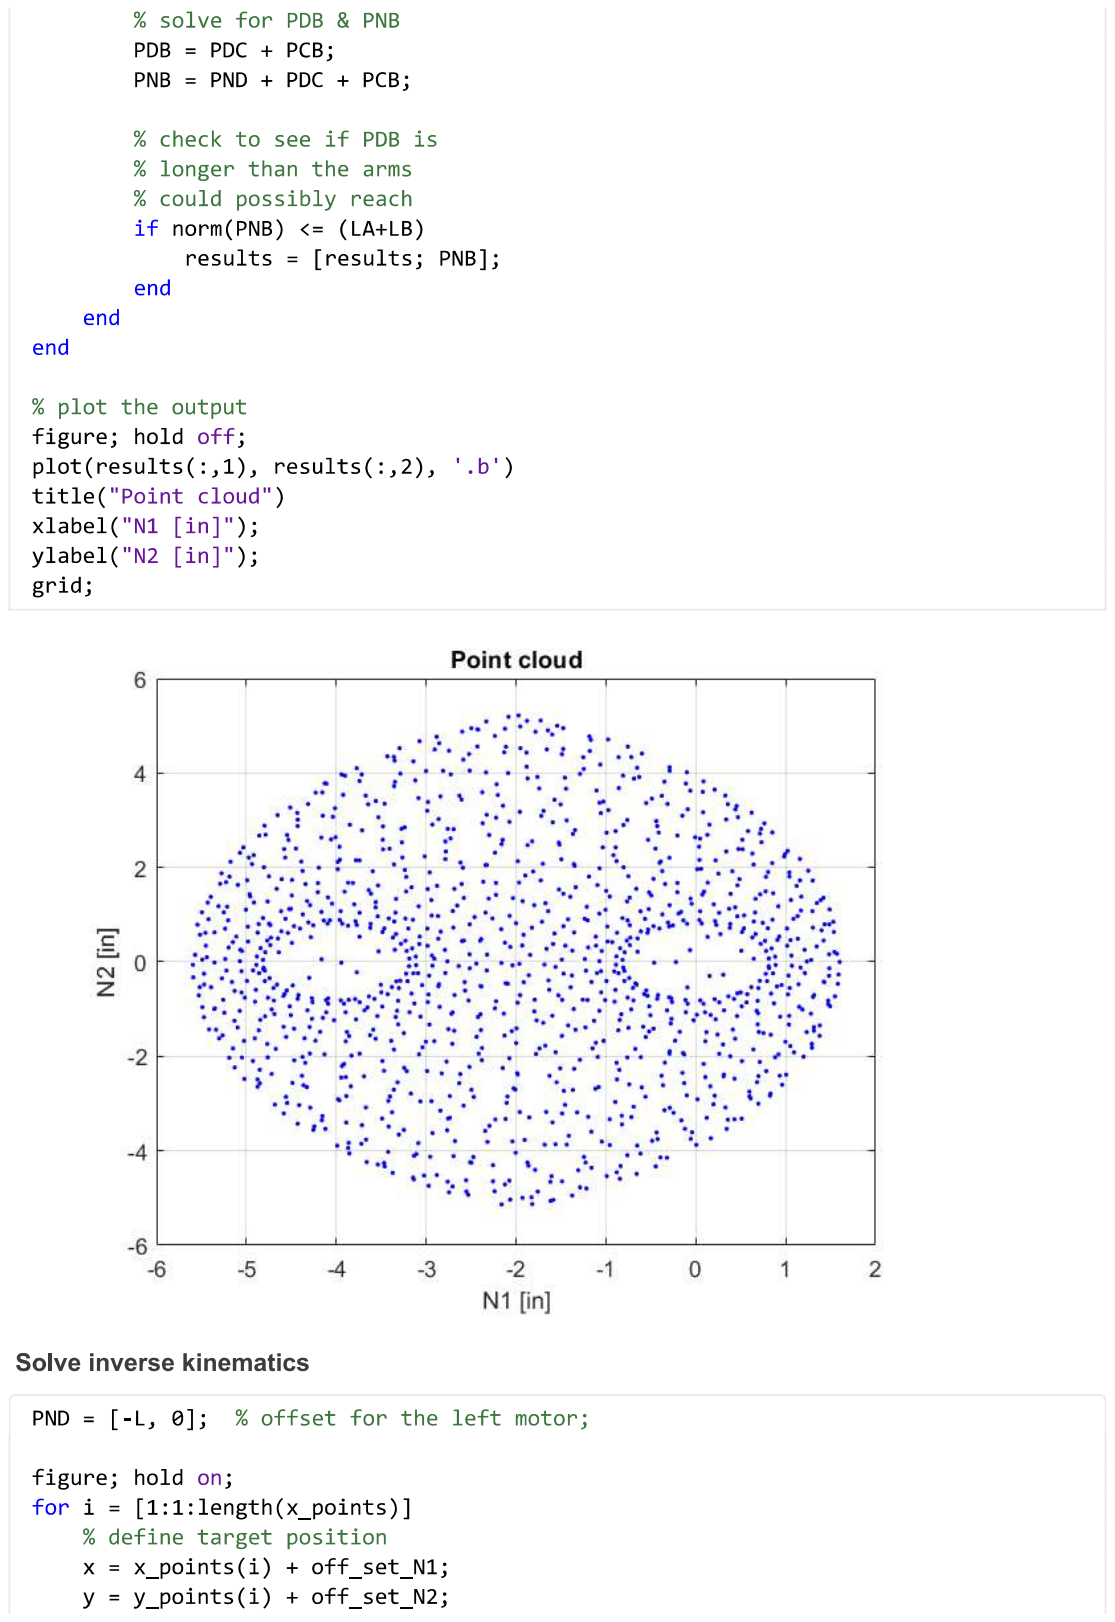
[picture p62: page 8]

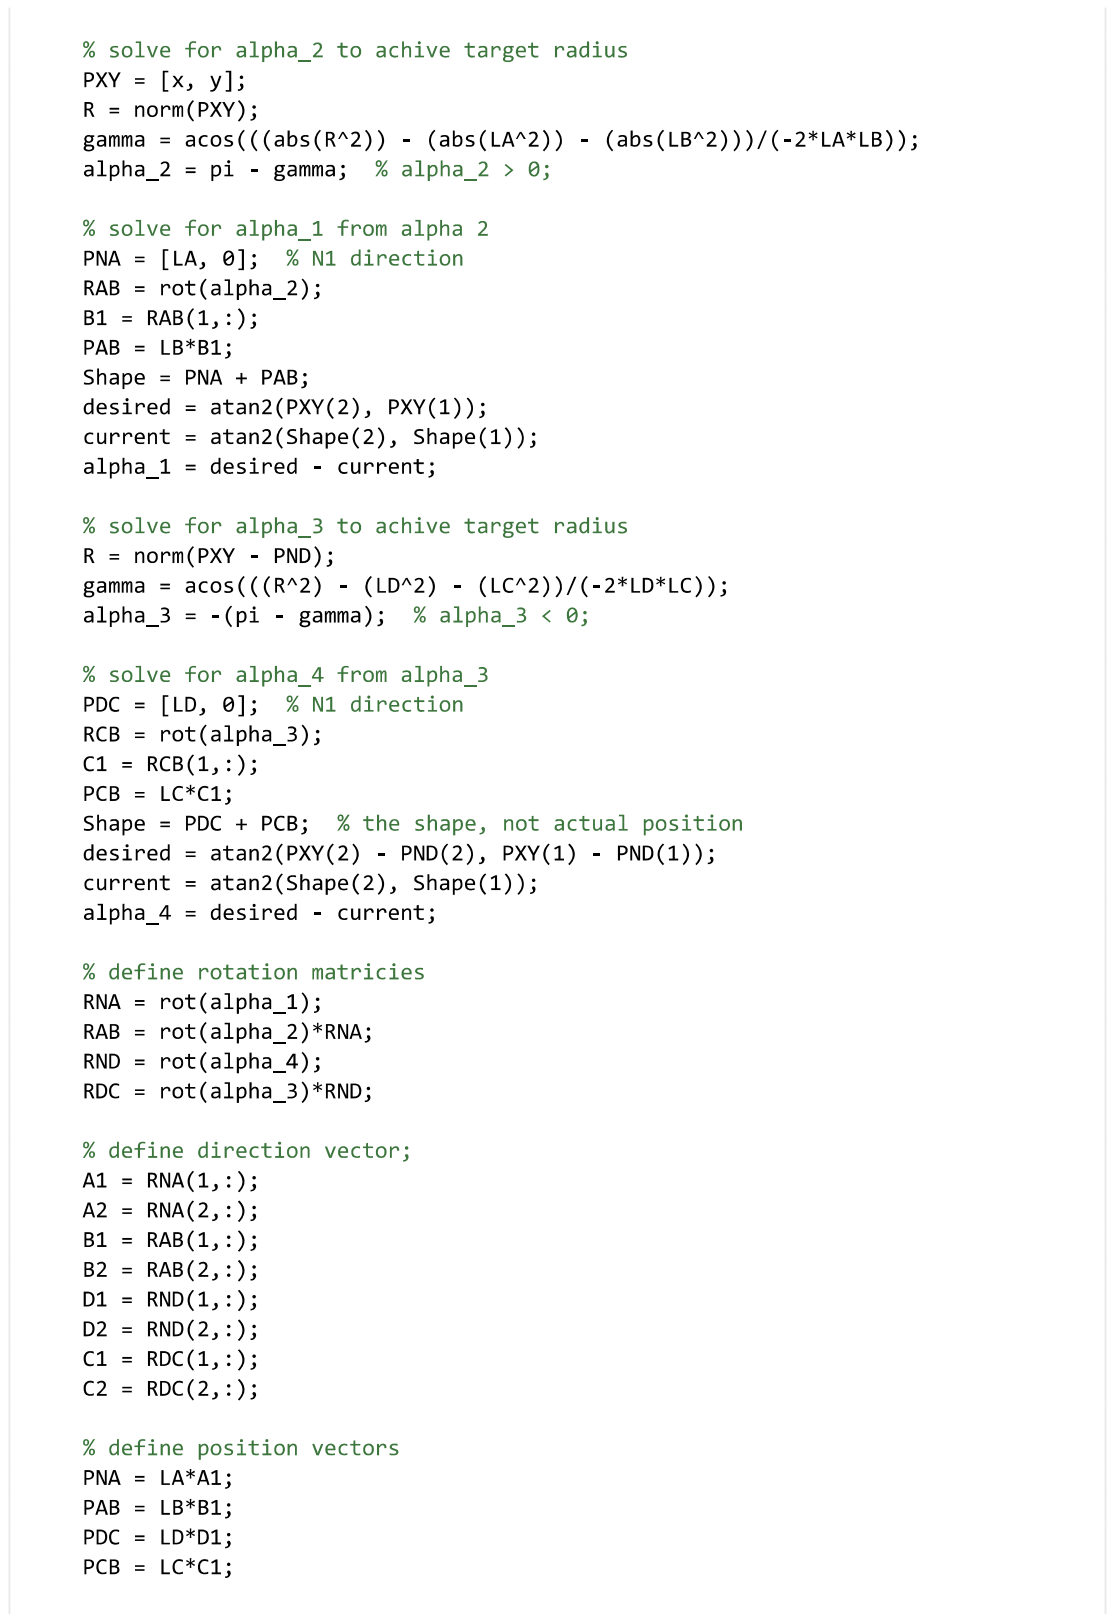
[picture p63: page 9]

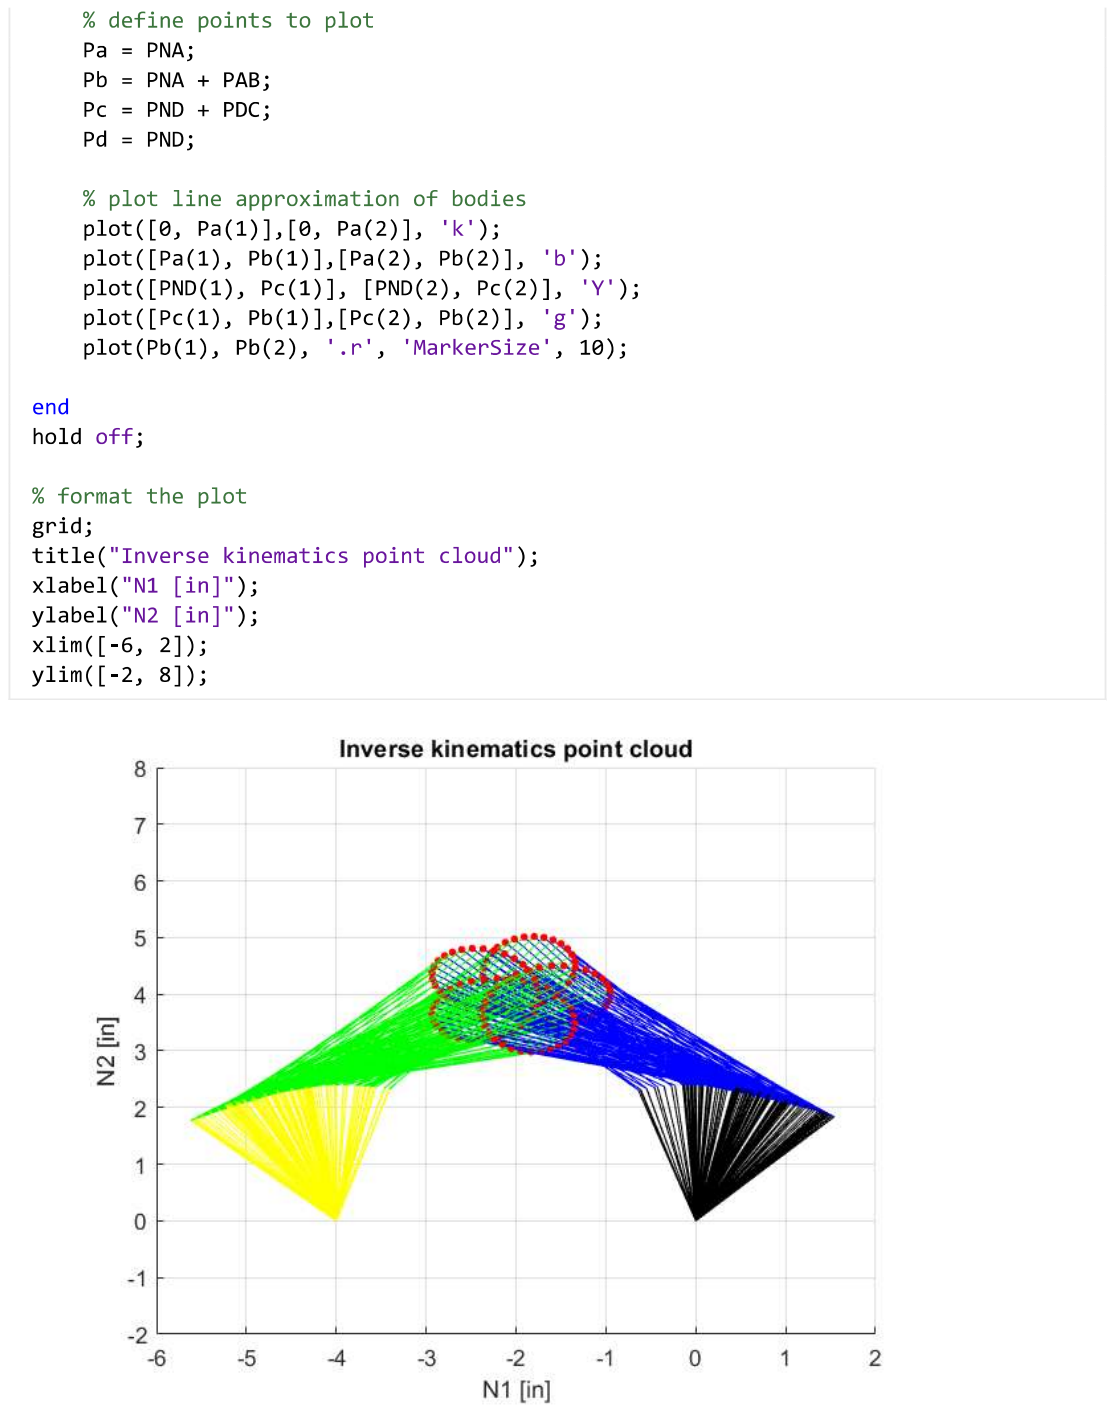
[picture p64: page 10]
