MrSamuelLaw/robo-hobos/pdf_files/Exercise1_Report_.pdf

# MAE 4345 Exercise 1 Samuel Law & Rhys Miller


Figure 1. Linkage with Frames, Lengths, and Angles

Figure 2. Point Cloud


ℒ
A


ℒ
B



ℒ
C


ℒ
D
