MrSamuelLaw/robo-hobos/(commit log)

2020-09-15 initial file dump
    [Encoder_Adaptor.SLDPRT, Sketch_Analysis.SLDPRT, asm_linkages.SLDASM, linkA.SLDPRT, linkA.STL, linkB.SLDPRT, linkC.SLDPRT, linkD.SLDPRT]
2020-09-15 fixed countersink issue with encoder adaptor
    [Encoder_Adaptor.SLDPRT]
2020-09-16 reduces stress concentrations by adding fillets to encoder adapter
    [Encoder_Adaptor.SLDPRT]
2020-09-17 motor and motor assembly
    [Encoder.SLDPRT, Encoder_Adaptor.SLDPRT, Gearmotor.SLDPRT, asm_motor_encoder_adapter.SLDASM]
2020-09-18 reverts the encoder to a solid body from a mesh body
    [Encoder_Adaptor.SLDPRT, asm_motor_encoder_adapter.SLDASM]
2020-09-18 adds the all possible positions point cloud to exercise1.mlx
    [Sketch_Analysis.SLDPRT]
2020-09-21 adds the forward kinematics to the matlab file
2020-09-21 adds print supports that can be rolled forward for 3D printing linkC
    [asm_linkages.SLDASM, linkC.SLDPRT]
2020-09-22 bearing spacer sleeves
    [Encoder.SLDPRT, Encoder_Adaptor.SLDPRT, Gearmotor.SLDPRT, asm_linkages.SLDASM, asm_motor_encoder_adapter.SLDASM, end_effector.SLDPRT, linkage_spacer.SLDPRT]
2020-09-22 adds sketches for the entire assembly to define locations and angles
    [Encoder_Adaptor.SLDPRT, Nframe.SLDPRT, asm_linkages.SLDASM, linkA.SLDPRT, linkB.SLDPRT, linkC.SLDPRT, linkD.SLDPRT]
2020-09-28 adjusts design to hold the different size bearings
    [Nframe.SLDPRT, asm_linkages.SLDASM, linkA.SLDPRT, linkB.SLDPRT, linkC.SLDPRT, linkD.SLDPRT]
2020-09-29 updates the geometery of the shims
    [Encoder.SLDPRT, Encoder_Adaptor.SLDPRT, Gearmotor.SLDPRT, Nframe.SLDPRT, asm_linkages.SLDASM, asm_motor_encoder_adapter.SLDASM, asm_robot.SLDASM, end_effector.SLDPRT]
2020-09-29 motor base
    [Motor Mount.SLDPRT]
2020-10-02 adds newest version of motor mount
    [Gearmotor.SLDPRT, Motor Mount.SLDPRT, Nframe.SLDPRT, asm_motor_encoder_adapter.SLDASM, asm_robot.SLDASM, linkA.SLDPRT, linkB.SLDPRT, linkC.SLDPRT]
2020-10-05 adds the drawing for the motor mounts and the wood and paper to the asm
    [asm_robot.SLDASM, asm_robot.SLDPRT, board_mount-drawing.DXF, paper.SLDPRT, wood_base.SLDPRT]
2020-10-12 adds the code to make the encoders read angles
    [end_effector.SLDPRT]
2020-10-16 encoder reader
    [Motor Mount.STL]
2020-10-28 Writeup drawing
    [Pendulum.SLDPRT]
2020-11-04 arduino code updates from 11_3_2020
    [Pendulum.SLDPRT, end_effector.SLDPRT]
2020-11-05 impliments a motor class, that once tuned can be used to control both motors
2020-11-05 polishes up the Motor class
2020-11-05 fixes errors in main
    [main.cpp]
2020-11-06 adds interupts for probing to the arduino
2020-11-17 adds content for exercise 3
    [asm_robot.SLDASM, linkD.SLDPRT, shaft_estimation.SLDPRT]
2020-11-23 adds some stuff
    [PD_10.csv, PD_100.csv, PD_1000.csv, PD_1000_actual.csv, PD_100_actual.csv, PD_10_actual.csv, asm_robot.SLDASM, joint_space_12rad.csv]
2020-11-25 impliments the task space controller
    [asm_robot.SLDASM]
2020-11-29 implements the joint space controller
2020-11-30 code refactored
    [asm_robot.SLDASM]
